nunosousa/AudioAmplifier/electronics/README.md

# Electronics

`audio-amplifier/` is the primary KiCad design. Its `dsp/` and `simulation/`
subdirectories keep tool-specific project data alongside the hardware design.
`datasheets/` holds component reference material used by the design.

Keep KiCad's top-level project file and all hierarchical sheets in
`audio-amplifier/`, because the sheet hierarchy uses relative paths.
