nunosousa/AudioAmplifier/mechanical/enclosure/README.md

# Enclosure CAD

- `source/` — editable native CAD files.
- `exports/` — neutral exchange formats, such as STEP and DXF.
- `drawings/` — released fabrication drawings and PDFs.

Use versioned filenames for released exports and drawings. Keep the editable
source that produced every released file in `source/`.
