nunosousa/AudioAmplifier/docs/ADAU1701_INTEGRATION.md

# ADAU1701 integration plan

This is a schematic-preparation guide for integrating the ADAU1701 into the
main 2.1 amplifier. It is not a finished schematic or a substitute for the
current Analog Devices datasheet and SigmaStudio documentation.

The package pin names/numbers below are transcribed from the embedded KiCad
symbol in [`dsp.kicad_sch`](../electronics/audio-amplifier/dsp.kicad_sch). Confirm every
pin function, electrical limit, recommended connection, component value, and
layout rule against the official
[ADAU1701 datasheet](https://www.analog.com/media/en/technical-documentation/data-sheets/ADAU1701.pdf)
before editing the circuit or releasing a board. Datasheet retrieval was not
available while preparing this plan, so no unverified component values are
specified here.

## Intended audio-channel mapping

The top-level sheet currently proposes these signal interfaces:

| Audio channel | Proposed DSP DAC | DSP-sheet outputs | Destination |
| --- | --- | --- | --- |
| Left | VOUT0 (pin 46) | `OUT_HIGH_P_LEFT`, `OUT_HIGH_N_LEFT` | Left differential input of stereo amplifier |
| Right | VOUT1 (pin 45) | `OUT_HIGH_P_RIGHT`, `OUT_HIGH_N_RIGHT` | Right differential input of stereo amplifier |
| Subwoofer | VOUT2 (pin 44) | `OUT_LOW_P`, `OUT_LOW_N` | Differential input of mono amplifier |
| Spare | VOUT3 (pin 43) | Not assigned | Reserve until channel needs are confirmed |

This is a proposed allocation, not a confirmed SigmaStudio routing. Verify it
against the DSP program before relying on the labels. The ADAU1701 has four
single-ended DAC outputs, whereas the three TPA3116D2 channels are presented
with differential input pairs. Therefore, the three proposed output pairs
require suitable analog output-driver circuits; the positive and negative
inputs must not be assumed to be separate DAC outputs or connected directly
to ground.

## Current SigmaStudio processing

The project owner reports that the current SigmaStudio design contains:

1. Bass and treble adjustment on the stereo input path. Each uses a DC Input
   Entry parameter to control a second-order filter block.
2. One DC Input Entry parameter controlling the cutoff frequency for the
   crossover filters: paired second-order high-pass sections for the stereo
   outputs (fourth-order overall) and paired second-order low-pass sections
   for the subwoofer output (fourth-order overall).
3. Separate master-volume blocks for the stereo outputs and the subwoofer
   output.

These are functional processing blocks in the SigmaStudio project; the
hardware/control path that will set their parameters is still undecided. A
SigmaStudio DC Input Entry value does not, by itself, define a physical knob,
controller, user interface, or persistent setting.

Before calling the crossover Linkwitz–Riley, inspect its actual biquad
coefficients and response. Cascading two identical second-order Butterworth
sections at the same cutoff yields a fourth-order Linkwitz–Riley response
(nominally -6 dB per branch at crossover); a generic fourth-order Butterworth
filter has different section Q values and a different crossover sum. Confirm
that the high- and low-pass branches use the intended response, share the same
cutoff parameter, and sum correctly in magnitude and phase with the intended
speaker polarity and acoustic alignment.

The cutoff control should update all affected stereo high-pass and mono
low-pass coefficients together. Check the SigmaStudio implementation to ensure
the coefficient changes remain stable throughout the allowed range and do not
cause audible zipper noise; use suitable parameter smoothing or a controlled
update if needed. Limit the adjustment range to values supported by the
filters, sample rate, speakers, and output-stage headroom.

The owner intends one shared master volume for all outputs plus a separate
subwoofer level trim. Map the stereo and subwoofer volume blocks to that
behavior (the stereo block provides master volume; the subwoofer block
combines master volume with the additional subwoofer trim, or an equivalent
DSP arrangement). Verify mute behavior, startup gain, parameter limits, and
clipping/headroom across all outputs.

## Pin-by-pin connection checklist

“Required treatment” describes what the schematic must account for. It does
not prescribe a final strap, rail, or component value.

| Pin | Name | Planned treatment | Status in current DSP sheet |
| ---: | --- | --- | --- |
| 1 | AGND | Connect to the analog ground reference per the vendor layout guidance. | Open |
| 2 | ADC0 | Condition and connect one line-input channel; verify common-mode, range, and anti-alias filtering. | Open |
| 3 | ADC_RES | Use the datasheet-specified 18 kohm, 1% external resistor for the selected 48 kHz sample rate. | Open |
| 4 | ADC1 | Condition and connect the other line-input channel; verify common-mode, range, and anti-alias filtering. | Open |
| 5 | `~{RESET}` | Define reset state and release timing; choose pull-up/reset supervision as needed. | Open |
| 6 | SELFBOOT | Strap for the selected startup method; document whether external EEPROM self-boot is used. | Open |
| 7 | ADDR0 | Strap/select only as required by the chosen control-bus configuration. | Open |
| 8 | MP4 | Assign a documented GPIO/serial function or set a defined unused state. | Open |
| 9 | MP5 | Assign a documented GPIO/serial function or set a defined unused state. | Open |
| 10 | MP1 | Assign a documented GPIO/serial function or set a defined unused state. | Open |
| 11 | MP0 | Assign a documented GPIO/serial function or set a defined unused state. | Open |
| 12 | DGND | Connect to the ground reference per the vendor layout guidance. | Open |
| 13 | DVDD | Connect to the datasheet-specified digital supply and local decoupling. | Open |
| 14 | MP7 | Assign a documented GPIO/serial function or set a defined unused state. | Open |
| 15 | MP6 | Assign a documented GPIO/serial function or set a defined unused state. | Open |
| 16 | MP10 | Assign a documented GPIO/serial function or set a defined unused state. | Open |
| 17 | VDRIVE | Use only as specified for the supported interface voltage; do not treat as a general-purpose supply. | Open |
| 18 | IOVDD | Connect to the datasheet-specified I/O supply and local decoupling. | Open |
| 19 | MP11 | Assign a documented GPIO/serial function or set a defined unused state. | Open |
| 20 | ADDR1/CDATA/WB | Configure for the selected control/self-boot interface; make the strap and bus function explicit. | Open |
| 21 | CLATCH/WP | Connect/configure for the selected control/self-boot interface. | Open |
| 22 | SDA/COUT | Connect/configure for the selected control/self-boot interface; add required pull-ups if applicable. | Open |
| 23 | SCL/CCLK | Connect/configure for the selected control/self-boot interface; add required pull-ups if applicable. | Open |
| 24 | DVDD | Connect to the specified digital supply and local decoupling. | Open |
| 25 | DGND | Connect to the ground reference per the vendor layout guidance. | Open |
| 26 | MP9 | Assign a documented GPIO/serial function or set a defined unused state. | Open |
| 27 | MP8 | Assign a documented GPIO/serial function or set a defined unused state. | Open |
| 28 | MP3 | Assign a documented GPIO/serial function or set a defined unused state. | Open |
| 29 | MP2 | Assign a documented GPIO/serial function or set a defined unused state. | Open |
| 30 | RSVD | Apply the exact reserved-pin treatment in the datasheet; do not infer a connection from the symbol’s passive type. | Open |
| 31 | OSCO | Connect only as required by the selected crystal/clock topology. | Open |
| 32 | MCLKI | Provide the master clock using a datasheet-compliant source and layout. | Open |
| 33 | PGND | Connect to the specified ground reference with the vendor-recommended layout. | Open |
| 34 | PVDD | Connect to the specified supply and local decoupling. | Open |
| 35 | PLL_LF | Add the specified loop-filter network with vendor-recommended placement. | Open |
| 36 | AVDD | Connect to the specified analog supply and local decoupling. | Open |
| 37 | AGND | Connect to the analog ground reference per the vendor layout guidance. | Open |
| 38 | PLL_MODE0 | Strap for the selected master-clock/PLL operating mode. | Open |
| 39 | PLL_MODE1 | Strap for the selected master-clock/PLL operating mode. | Open |
| 40 | CM | Add the specified common-mode bypass/filter connection. | Open |
| 41 | FILTD | Add the specified DAC filter connection and place it close to the IC. | Open |
| 42 | AGND | Connect to the analog ground reference per the vendor layout guidance. | Open |
| 43 | VOUT3 | Reserve as the spare DAC unless the channel plan changes; provide the specified output network if used. | Open |
| 44 | VOUT2 | Proposed subwoofer DAC; add its output network and differential driver. | Open |
| 45 | VOUT1 | Proposed right-channel DAC; add its output network and differential driver. | Open |
| 46 | VOUT0 | Proposed left-channel DAC; add its output network and differential driver. | Open |
| 47 | FILTA | Add the specified ADC filter connection and place it close to the IC. | Open |
| 48 | AVDD | Connect to the specified analog supply and local decoupling. | Open |

The repeated supply and ground pins are intentional: connect every package pin.
Use the datasheet's recommended decoupling, ground, and placement scheme rather
than treating the repeated pins as optional.

## Circuit blocks to draw

### 1. Power and reference

- Choose the system input supply and derive every ADAU1701 rail from the
  datasheet limits and the rest of the design.
- Show each supply domain separately (`AVDD`, `DVDD`, `PVDD`, `IOVDD`) even
  where they ultimately share a source. Identify any filtering or ferrite
  isolation, and place decoupling at the corresponding device pins.
- Connect all ground pins. Plan a continuous, low-impedance reference and
  partition noisy Class-D return-current paths by placement/routing rather
  than introducing an unreviewed ground split.
- Add the ADC reference, PLL loop filter, DAC/ADC filter capacitors, and
  common-mode bypass exactly as specified by the current datasheet.

**Still needed:** supply voltage/current budget, rail architecture, regulator
choices, and datasheet-verified component values.

### 2. Clock, reset, boot, and control

- Select either a crystal/resonator or external master-clock source and define
  its frequency and startup behavior. Configure both PLL mode pins accordingly.
- Choose and document the boot path: for example, self-boot from an external
  EEPROM or program/configure the DSP from a controller. Check that the selected
  strap states and pin multiplexing support the chosen path.
- Define the roles of the multifunction pins before assigning GPIOs or serial
  audio ports. Give every unused input or multifunction pin a documented,
  datasheet-compliant state.
- The current UI proposal uses an RP2350 with a 320 × 240 colour display, one
  rotary encoder, and dedicated parameter buttons to update master volume,
  bass, treble, sub trim, and crossover values. Spectrum and VU views require
  DSP level/spectrum telemetry in addition to parameter control. Define the
  display, parameter-control, telemetry, GPIO, and SWD interfaces; reserve
  debug access and verify target-voltage and probe requirements.
- Specify control-bus wiring, pull-ups/logic voltage, address straps, reset
  ownership, DSP parameter-update mechanism, and relationship to amplifier
  mute and power control.

**Still needed:** boot method, exact MCU, master-clock source, and confirmed
parameter interface.

### 3. Stereo ADC input conditioning

- Preserve left/right channel identity from the input connector through the
  preamp to ADC0/ADC1 and into the SigmaStudio project.
- The ADAU1701 ADC inputs are current inputs, not conventional voltage inputs.
  At 48 kHz, the datasheet specifies 100 uA rms full scale with an external
  18 kohm ADC_RES resistor (20 kohm including the internal 2 kohm). The ADC
  input pins sit at approximately 1.5 V common mode.
- At 48 kHz, choose each ADC0/ADC1 external series resistor from the desired
  full-scale input voltage:
  `R_input,total = V_input,FS(rms) * 10 kohm`, and
  `R_input,external = R_input,total - 2 kohm` (the internal input resistance).
  The selected target is 2.0 Vrms full scale, so use 18 kohm external series
  resistors for ADC0 and ADC1. Keep ADC_RES at 18 kohm external for 48 kHz.
  Use 1% resistors and verify the datasheet's recommended matching relationship.
  This nominally maps 0.5 Vrms to 25% full scale (about -12 dBFS) and 0.2 Vrms
  to 10% full scale (about -20 dBFS), before the small source-side loading
  loss.
- Current input specification: a pair of unbalanced RCA line inputs, expected
  source impedance 50 ohm to 2.5 kohm, 0.5 Vrms nominal, 0.2 Vrms minimum,
  5.65 Vpp maximum, with a superimposed DC component from 0 V to +1 V. The
  impedance range is a reasonable broad design target, but verify the actual
  source and any SCART-to-RCA adapter documentation: SCART is a connector
  standard, not a guarantee of identical audio output impedance or level from
  every device.
- The proposed signal path in the preamp schematic is a 100 ohm series resistor
  and 1 nF shunt capacitor for first-order RF attenuation, followed by a
  220 kohm source-side drain resistor, 22 uF series coupling capacitor, and
  100 kohm bias resistor to +4.5 V (V/2). The conditioned signal is buffered
  by a unity-gain voltage follower before the ADAU1701 ADC.
- The 100 ohm series resistor and 1 nF shunt capacitor form the input RF
  low-pass. Including the 50 ohm to 2.5 kohm source impedance and the 220 kohm
  drain resistor, the estimated corner is approximately 1.06 MHz down to
  61.9 kHz, respectively. These estimates assume a low-impedance ground at
  the shunt capacitor and nominal component values. The filter attenuates RF
  above its corner; it is not a brick-wall filter and does not replace good
  connector, grounding, and layout practice.
- With the 22 uF coupling capacitor acting as a short at audio frequencies,
  the source sees approximately 220 kohm in parallel with the 100 kohm bias
  path (about 68.8 kohm), assuming the +4.5 V bias node is AC-stiff. A 2.5 kohm
  source would therefore cause roughly 3.6% level loss (about 0.32 dB) before
  other loading and tolerance effects. This is generally modest, but include
  the loading in gain/headroom calculations.
- With the source unplugged and ideal low-impedance ground and V/2 references,
  the 22 uF capacitor sees about 220 kohm + 100 kohm. This gives an approximate
  7.0 second time constant (about 0.023 Hz corner). The drain resistor helps
  prevent the source-side input node from floating, but this relatively long
  discharge time does not guarantee click-free hot-plugging. Source impedance
  changes the time constant while connected.
- The owner confirms that 5.65 Vpp means a maximum sine-wave input and that
  the +1 V DC offset may coexist with that signal. It is 2.0 Vrms and 2.825 V
  AC peak; with +1 V DC, the RCA source ranges from -1.825 V to +3.825 V.
  The source-side 22 uF capacitor blocks this DC component. The selected
  2.0 Vrms ADC full-scale target leaves no intentional headroom for a
  2.0 Vrms sine at the buffer output. Do not rely on the small and
  source-impedance-dependent passive input loss as headroom; account for
  source level tolerance and resistor tolerance, and verify clipping with the
  worst-case input.
- RCA inputs are user-accessible and hot-plugged. Decide the ESD and fault
  model (connector contact discharge, cable discharge, accidental DC/overload,
  and power-off conditions). Place a low-leakage, suitably low-capacitance
  protection device close to each RCA center pin, with a short return to the
  intended chassis/ESD return. Coordinate any signal-to-rail clamps with the
  100 ohm series resistor and ensure clamps cannot back-power unpowered analog
  rails. The 100 ohm resistor and 220 kohm drain are not, by themselves,
  robust ESD protection. Keep protection leakage and capacitance low enough to
  avoid bias error, RF-filter changes, or audible distortion.
- Ensure input protection does not clamp the normal audio waveform. A simple
  diode clamp from the RCA center pin to ground would conduct on the permitted
  negative audio swing and distort it. At the connector, choose a protection
  device whose stand-off/clamping behavior tolerates the defined normal
  envelope, or place any tighter clamp after the coupling capacitor at a
  correctly biased node. Verify protection against both the continuous
  operating range and the selected ESD/overload test levels.
- Treat the RCA shield as the audio return. Plan its connection to analog
  ground and chassis so cable/shield and ESD currents do not flow through
  sensitive DSP/op-amp return paths; finalize the chassis-grounding strategy
  with the enclosure and power-supply grounding plan.
- Verify the polarized coupling capacitor's positive terminal faces the
  +4.5 V bias side, with suitable voltage rating and leakage. Confirm that
  +4.5 V is sufficiently low-noise and low-impedance for both channel bias
  resistors, and verify the unity-gain follower configuration and supplies.
- **Critical ADC interface check:** biasing the follower input to +4.5 V
  means its output will also sit near +4.5 V DC. Do not connect that output
  directly to an ADAU1701 ADC pin: the ADC input common mode is about +1.5 V.
  A candidate interface is to AC-couple the follower output, then feed the ADC
  through the correctly sized 1% voltage-to-current series resistor; the ADC
  pin's internal common mode establishes its DC operating point. Verify this
  arrangement, coupling-capacitor polarity/value, current limits, and resistor
  matching against the current datasheet and an analog simulation before
  committing the circuit. Alternatively, redesign the buffer bias so its
  output common mode is compatible with the ADC input.
- Measure or establish the actual source impedance and output level for the
  intended RCA sources and SCART adapter. Check
  source loading, protection, component tolerances, op-amp output swing, and
  the ADAU1701 input-current full scale and clipping behavior at minimum,
  nominal, and maximum input. Record expected AC/DC levels at the connector,
  buffer output, and ADC pins.
- Keep amplifier mute active during power-up and DSP initialization; do not
  rely on the 220 kohm drain resistor alone to suppress connection or startup
  thumps.

### 4. Three DAC output-driver channels

For each of left, right, and subwoofer:

1. Assign one DAC channel and record the matching SigmaStudio output.
2. Add the datasheet-recommended DAC output network.
3. Design a driver that provides the required differential signal to one
   TPA3116D2 input pair, including correct amplitude, polarity, bias/common
   mode, and source impedance.
4. Verify the amplifier input limits and gain together with DSP output level
   and any intended equalization boost.
5. Add mute/startup behavior that avoids audible transients.

Do not treat an output pair named `P`/`N` in the hierarchy as a differential
output of the ADAU1701 itself: it is the proposed output of the external analog
driver. Keep a clear spare-channel policy for VOUT3.

**Still needed:** intended amplifier gain, required DAC-to-amplifier level,
driver topology, component availability, and whether a shared or per-channel
mute is required.

## Requirements to settle before final values

- Exact RCA source/SCART-adapter behavior and connector/chassis grounding;
  confirm whether the specified maximum AC level and +1 V DC offset can occur
  simultaneously and establish absolute peak limits.
- Required supply input, available power, speaker impedance, and target output
  power per channel.
- Crossover frequency and response, subwoofer summing rule, EQ range/boost,
  and master-volume range.
- Front-panel electrical details (display controller/interface, encoder/button
  circuits, parameter ranges, startup defaults, saved-setting policy, and DSP
  level/spectrum telemetry).
- Whether the design needs selectable inputs, status indication, fault
  reporting, or firmware-updatable DSP parameters.

## Bring-up and validation checklist

- [ ] Review each of the 48 package pins against the current datasheet.
- [ ] Run KiCad ERC; resolve errors and document intentional exceptions.
- [ ] Generate the KiCad netlist and confirm ADC, DAC, supply, clock, reset,
      control-bus, and mute nets.
- [ ] Before powering the DSP, verify the ADC input path against the datasheet:
      18 kohm, 1% external resistors at ADC0/ADC1 and ADC_RES at 48 kHz;
      confirm the external ADC_RES resistor is actually connected and the
      three resistors meet the specified matching/tolerance guidance.
- [ ] Check the polarity and DC ratings of the source-side and buffer-output
      coupling capacitors. Confirm the follower output is AC-coupled before
      each ADC resistor and that no +4.5 V DC path reaches an ADC pin.
- [ ] With power amplifiers disconnected and the audio/control rails current
      limited, verify analog supplies, V/2 bias, op-amp input/output common
      modes, and ADC pin DC common mode before applying a signal.
- [ ] Apply a known 1 kHz sine at nominal 0.5 Vrms, then verify both channels'
      ADC input levels and channel mapping. Increase toward the specified
      2.0 Vrms maximum only after confirming the analog stage remains within
      its input/output limits; confirm ADC clipping is absent at the intended
      maximum and document the actual margin.
- [ ] Test representative source impedances at the design endpoints (50 ohm
      and 2.5 kohm), and verify input loading, channel balance, low-frequency
      response, RF-filter behavior, and recovery after signal removal.
- [ ] If testing the specified +1 V source DC offset, first verify all
      component/op-amp ratings and use the source-side coupling capacitor;
      measure the ADC-side DC common mode and ensure the offset does not pass
      through to the ADC.
- [ ] Keep the power amplifiers disconnected until ADC scaling, clipping,
      mute/startup sequencing, and output-stage levels have been verified.
- [ ] Verify the SigmaStudio design has the same ADC/DAC channel mapping and
      startup parameter values as the schematic.
- [ ] Test input clipping margin and output levels at minimum/nominal/maximum
      input.
- [ ] Measure left/right/sub frequency response, crossover summing, phase,
      channel balance, noise, and mute/startup transients.
- [ ] Check the DSP and output-driver supplies for noise under Class-D load.

## Current repository-specific findings

- The parent hierarchy currently carries `IN_LEFT` and `IN_RIGHT` into the DSP
  sheet from the reduced preamp, and carries six proposed differential outputs
  toward the stereo and mono TPA3116D2 sheets.
- The DSP sheet now has 18 kohm series resistors on the two ADC inputs and
  partial wiring to the ADAU1701. The required external ADC_RES resistor is
  still absent, resistor tolerance/matching is not recorded, and the DSP
  power, clock, reset, boot, and other required pin circuitry remain
  incomplete. The schematic is not ready to power or fabricate.
- The preamplifier sheet now AC-couples the two buffered outputs before they
  enter the DSP sheet. Verify the output-coupling capacitor polarity and
  confirm the ADC pins remain at their datasheet-specified common mode.
- The owner-reported SigmaStudio chain includes bass and treble filters, a
  shared adjustable crossover cutoff, and separate stereo/subwoofer volume
  blocks. The intended control behavior is one shared master volume plus a
  subwoofer trim. Verify that the actual SigmaStudio graph implements that
  behavior, and check the generated files together before hardware bring-up.
- The parent `MCU` sheet is empty. The controller need is therefore an
  architecture decision, not an implemented feature.
- The current PCB is empty and needs to be rebuilt after the DSP sheet and its
  analog interface are complete.
