nunosousa/AudioAmplifier/electronics/audio-amplifier/simulation/Filter Design.xlsx

Fourth-order Sallen & Key Butterworth highpass filter, implemented in two stages. Type: Linkwitz-Riley
two cascaded 2nd-order Butterworth filters with the same cutoff frequency
 | Calculated
Q | 0.7071067812
f0 | 120 | Hz
 |  |  |  |  | Prefered
R2 | 10000 | Ω | → | R2 | 10000 | Ω
R1 | 5000 | Ω | → | R1 | 5000 | Ω
C1, C2 | 187.5658992 | nF | → | C1, C2 | 200 | nF
 |  |  |  | Q | 0.7071067812
 |  |  |  | f0 | 112.5395395 | Hz
Fourth-order Sallen & Key Butterworth lowpass filter, implemented in two stages. Type: Linkwitz-Riley
two cascaded 2nd-order Butterworth filters with the same cutoff frequency
 | Calculated
Q | 0.7071067812
f0 | 120 | Hz
 |  |  |  |  | Prefered
C2 | 100 | nF | → | C2 | 100 | nF
C1 | 200 | nF | → | C1 | 200 | nF
R1, R2 | 9378.29496 | Ω | → | R1, R2 | 10000 | Ω
 |  |  |  | Q | 0.7071067812
 |  |  |  | f0 | 112.5395395 | Hz
