nunosousa/AudioAmplifier/electronics/archive/README.md

# Legacy source material

This directory holds unintegrated design source retained for historical
reference. Nothing here is part of the active KiCad sheet hierarchy or the
current product scope.
