nunosousa/AudioAmplifier/docs/archive/README.md

# Archived interface studies

These are superseded concepts retained for design history. They are not current
hardware or firmware requirements.

`front-panel-seven-segment.svg` documents the previous five-control,
seven-segment front-panel proposal. The active design is described in
`../FRONT_PANEL.md`.
