nunosousa/AudioAmplifier/electronics/audio-amplifier/AudioAmplifier.pdf

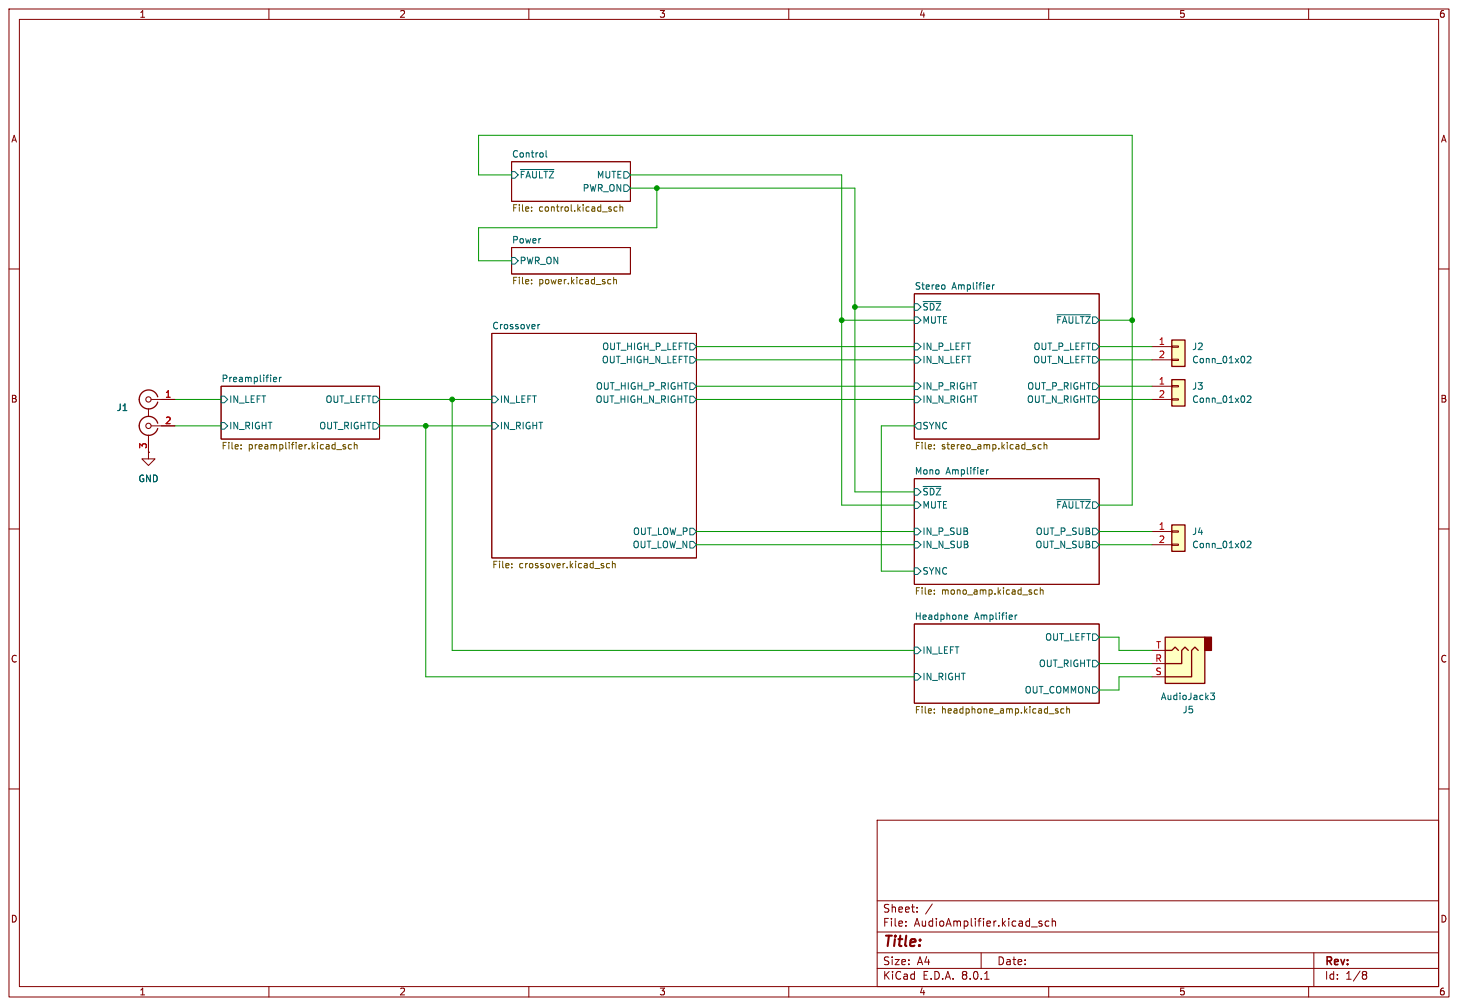
[picture p2: page 1]

SYNC Mono Amplifier File: mono_amp.kicad_sch

Id: 1/8 Title: File: AudioAmplifier.kicad_sch Sheet: /

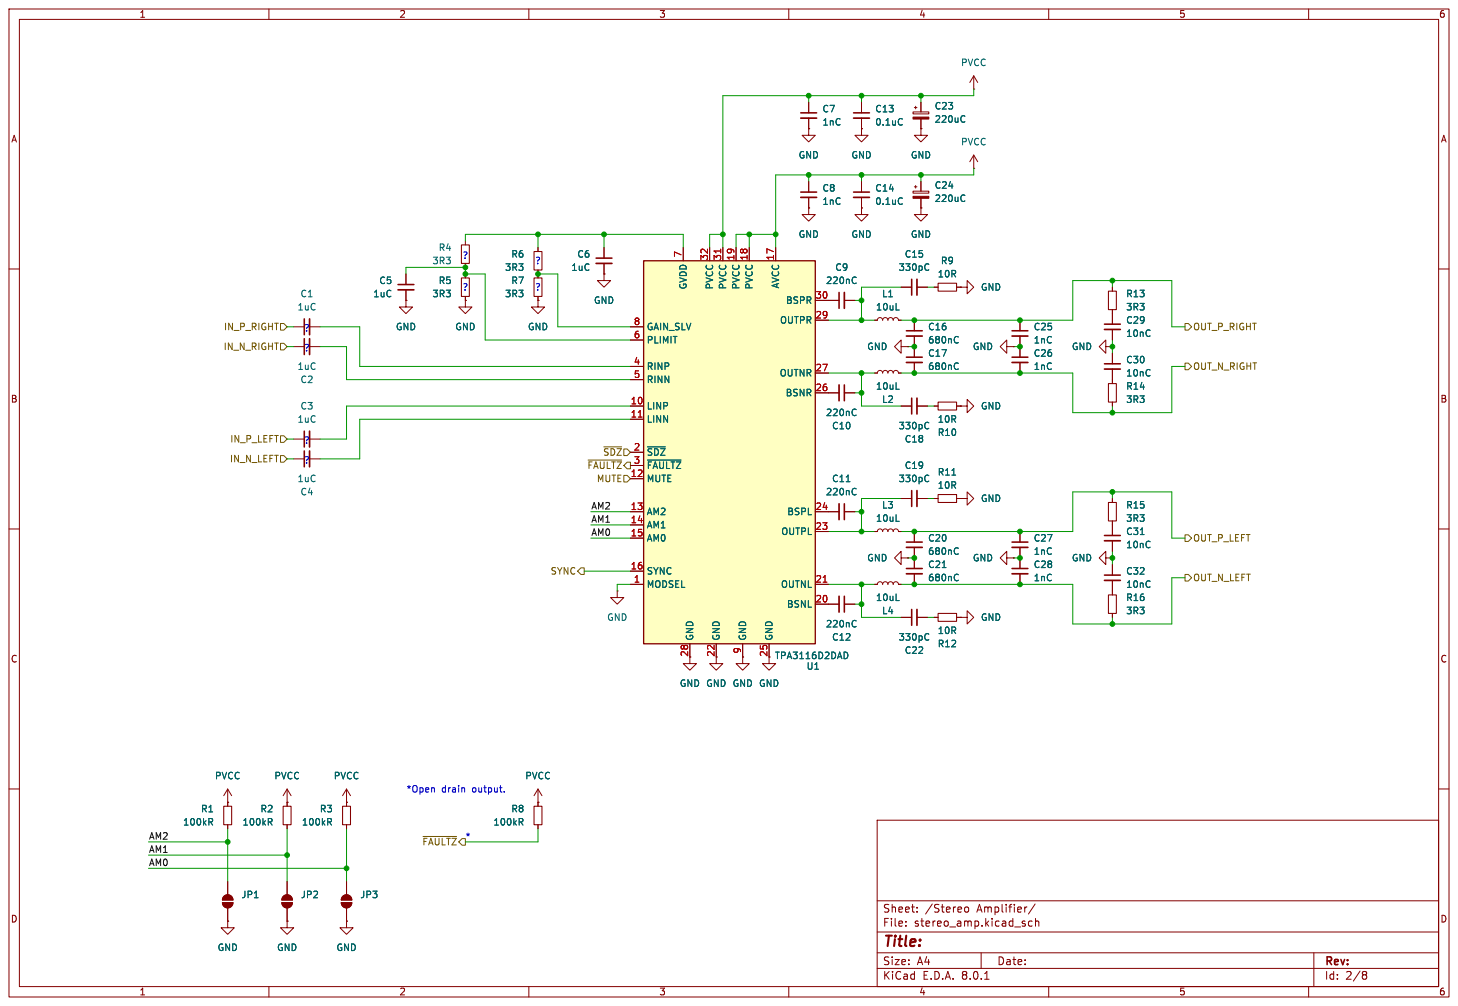
[picture p3: page 2]

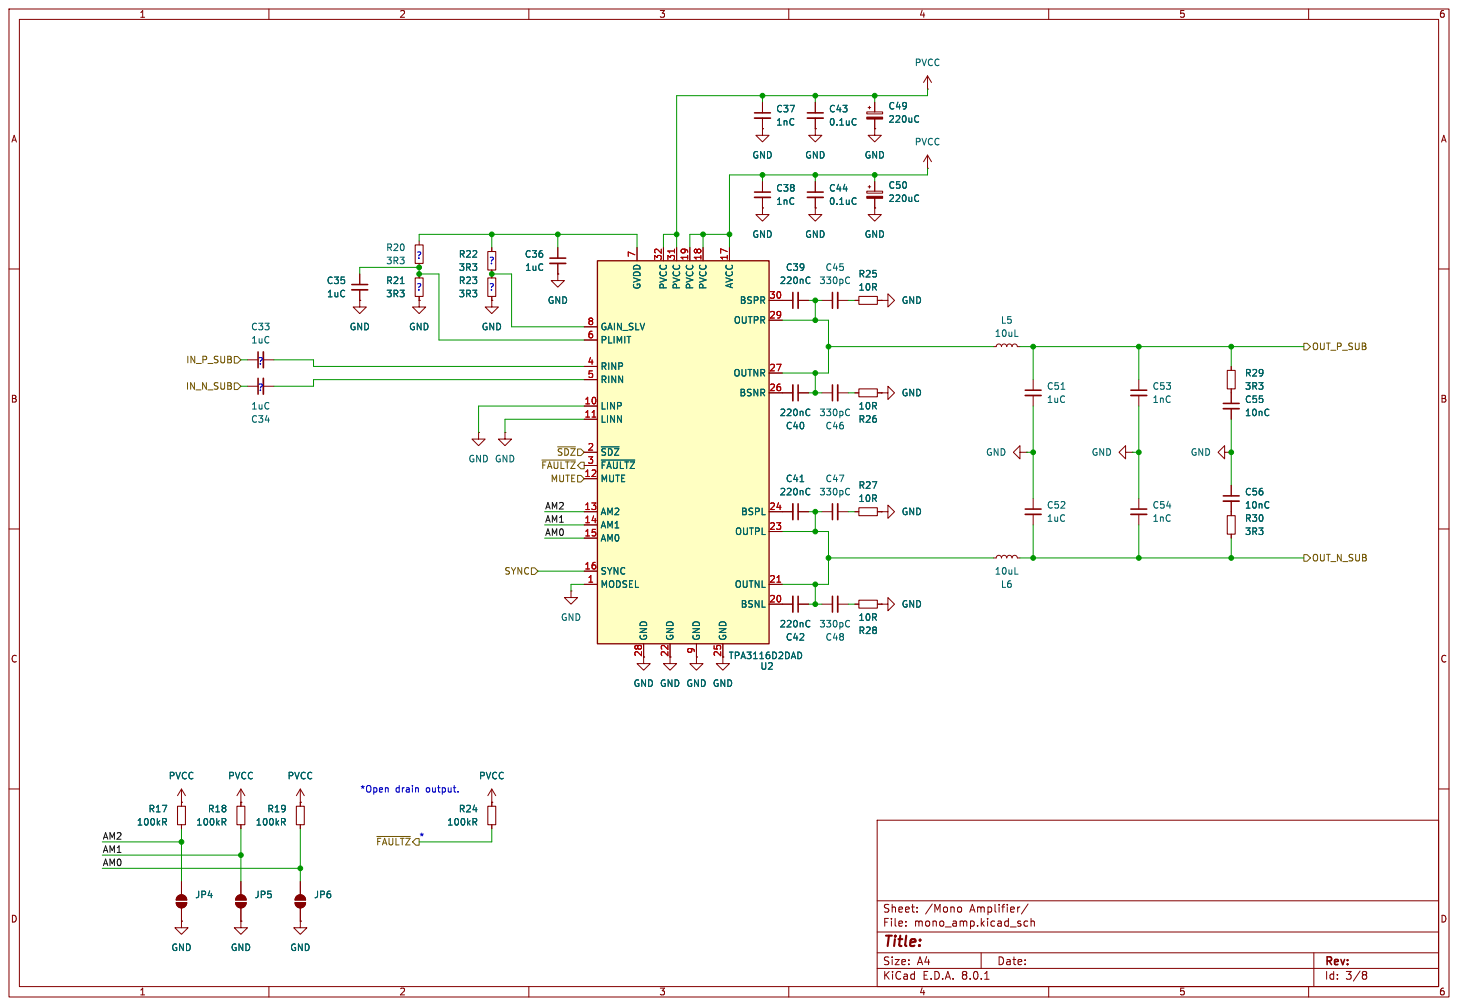
[picture p4: page 3]

9 GND GND GND GND

Id: 3/8 Title: File: mono_amp.kicad_sch Sheet: /Mono Amplifier/ JP6 R19

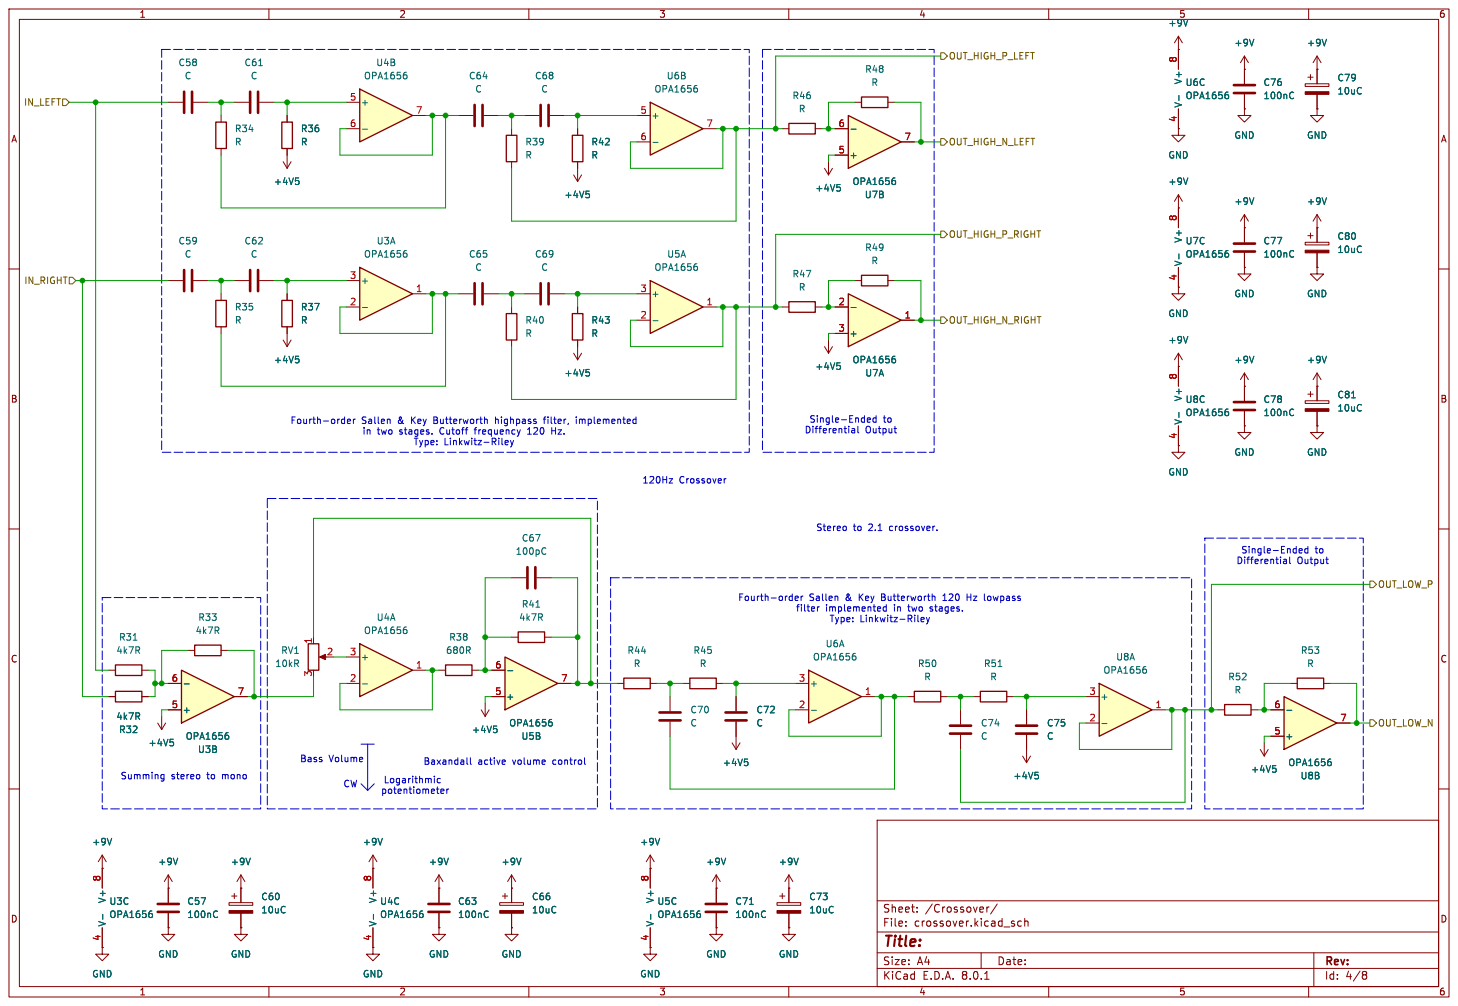
[picture p5: page 4]

potentiometer Bass Volume CW

Id: 4/8 Title: File: crossover.kicad_sch Sheet: /Crossover/

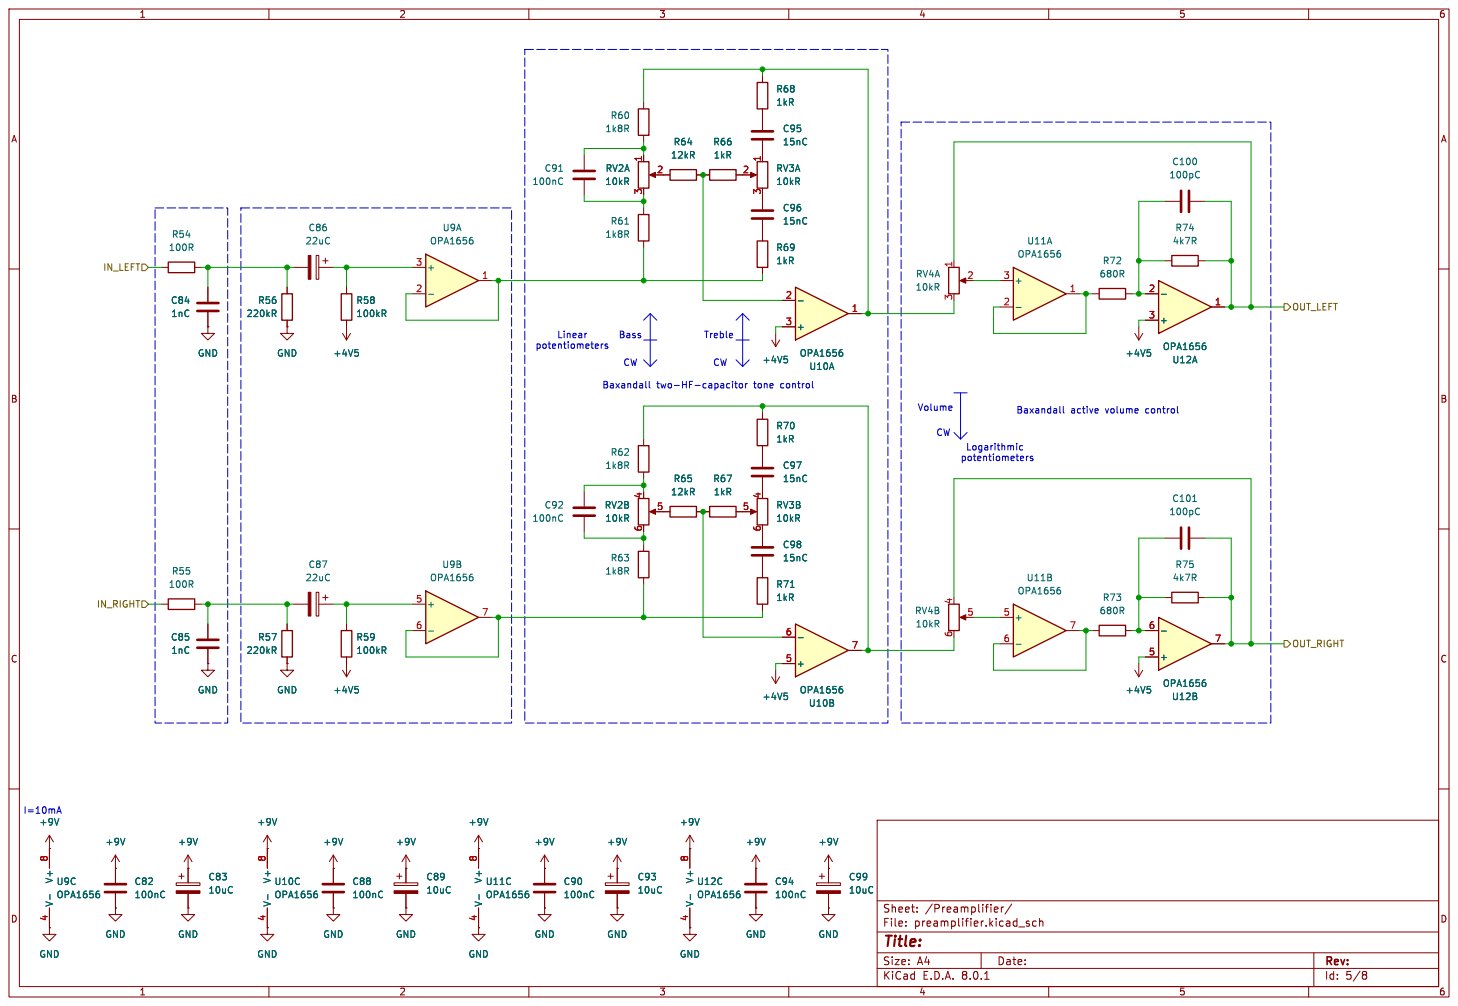
[picture p6: page 5]

Id: 5/8 Title: File: preamplifier.kicad_sch Sheet: /Preamplifier/

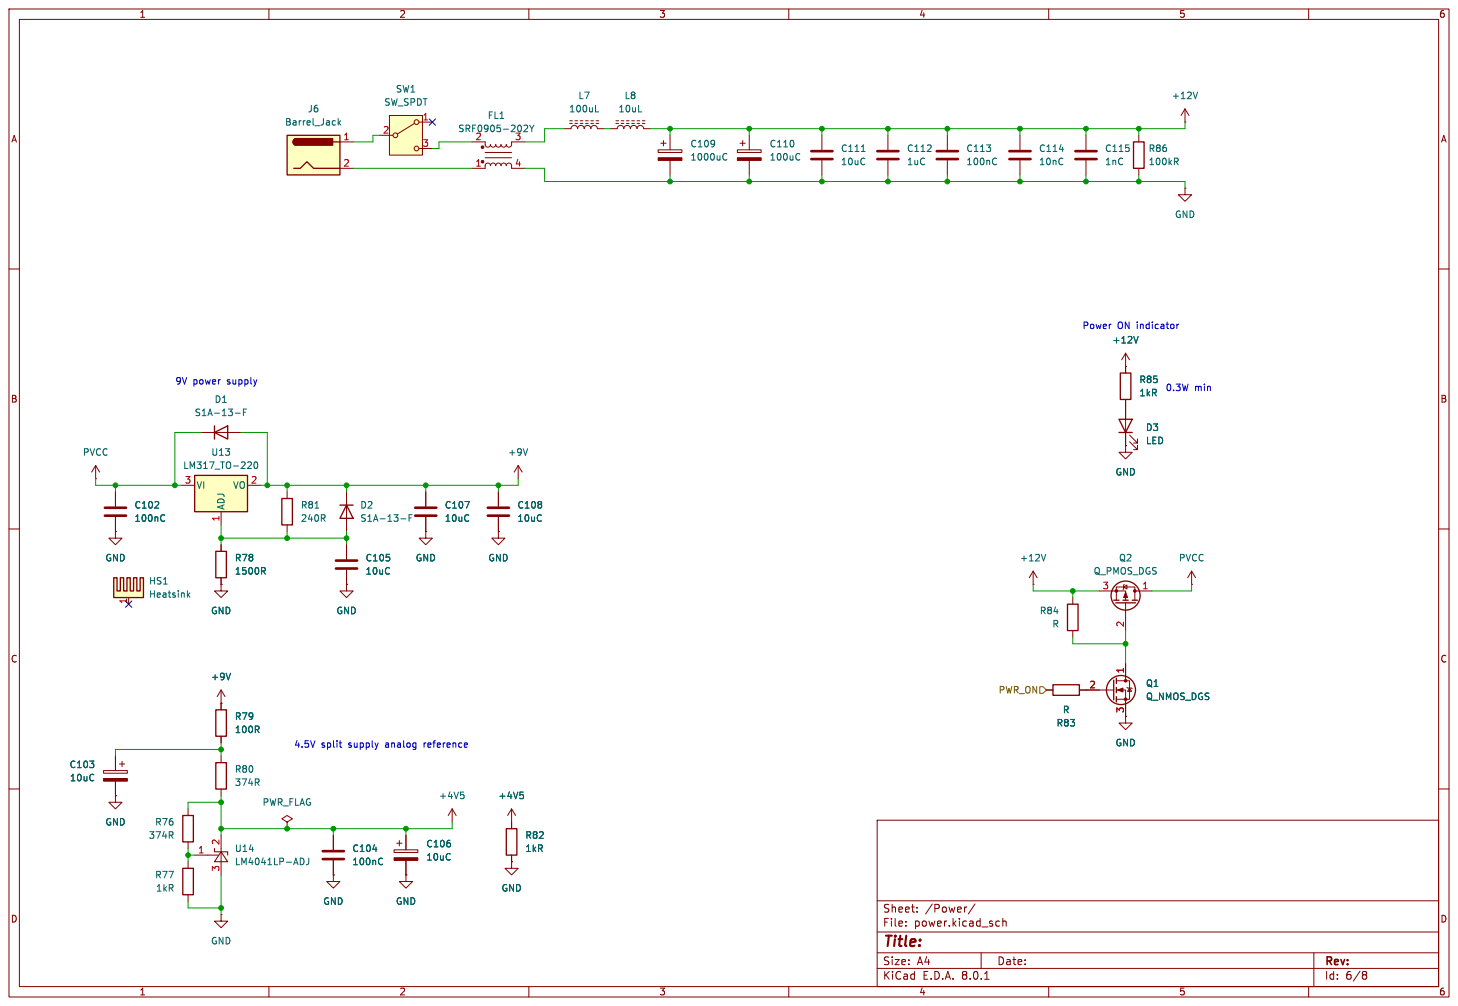
[picture p7: page 6]

0.3W min Power ON indicator 4.5V split supply analog reference

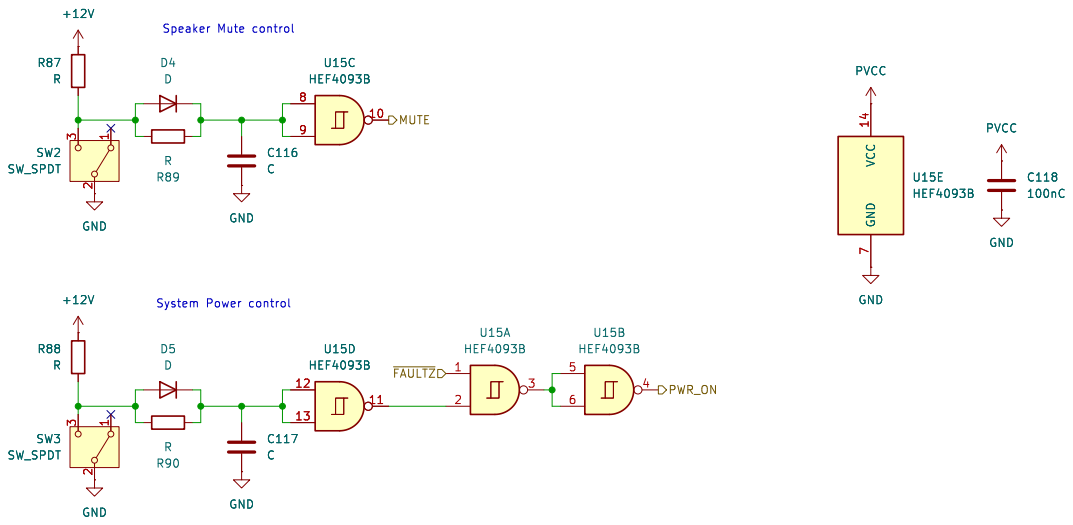
[picture p8: page 7]

Id: 7/8 Title: File: control.kicad_sch Sheet: /Control/ 1

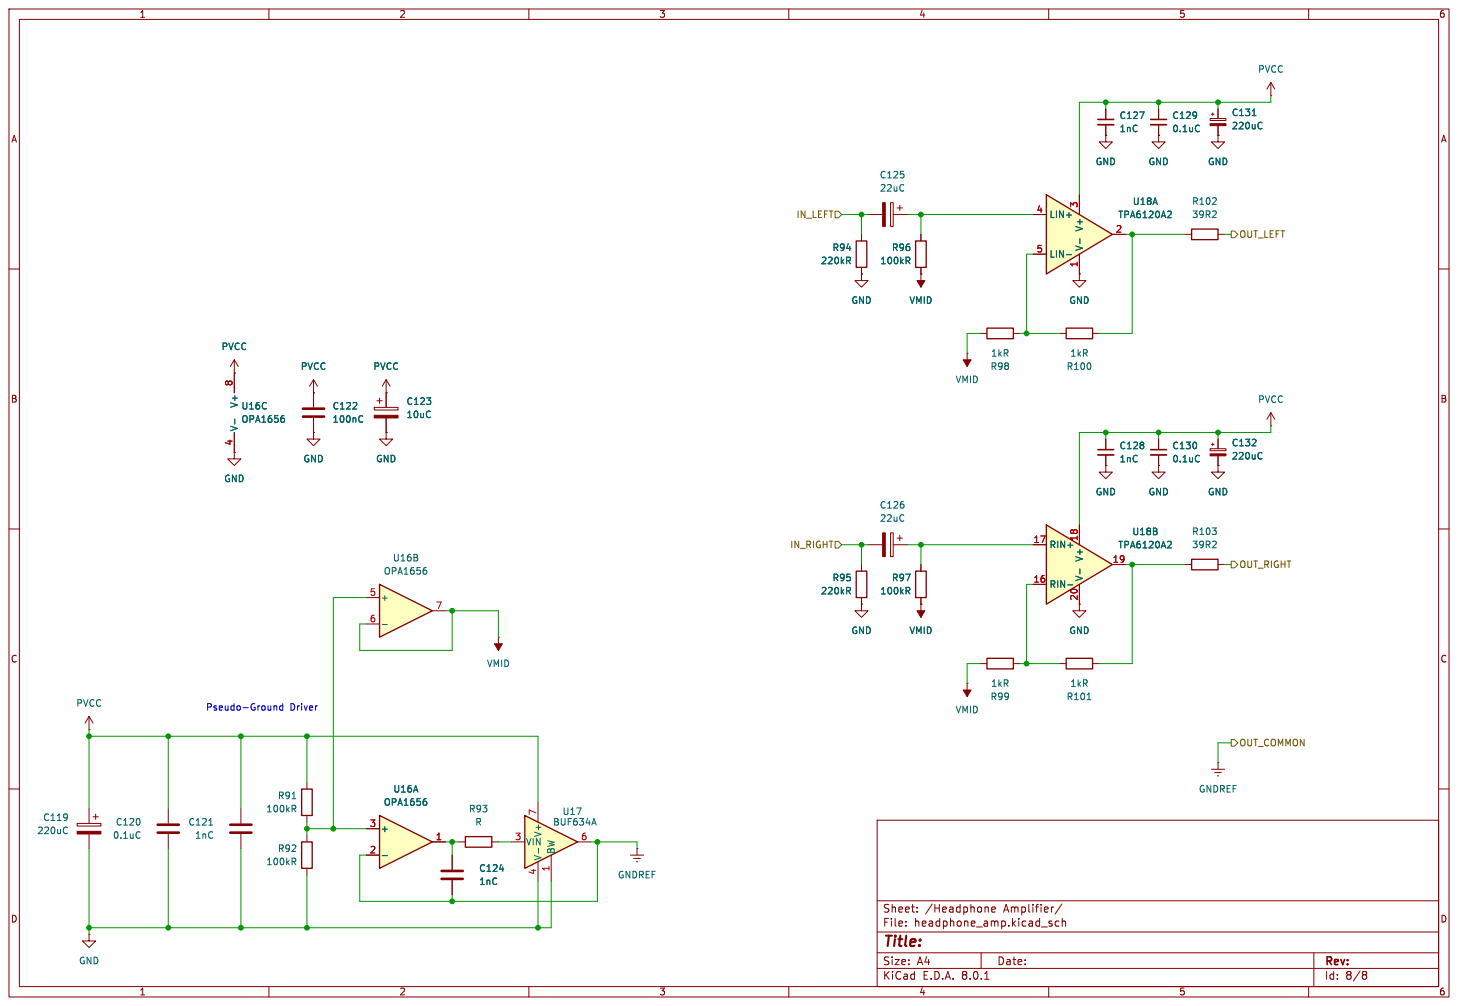
[picture p9: page 8]
