nunosousa/AudioAmplifier/electronics/audio-amplifier/AudioAmplifier.kicad_sch

## KiCad design electronics/audio-amplifier/AudioAmplifier.kicad_sch (2026-11-09, an earlier design)

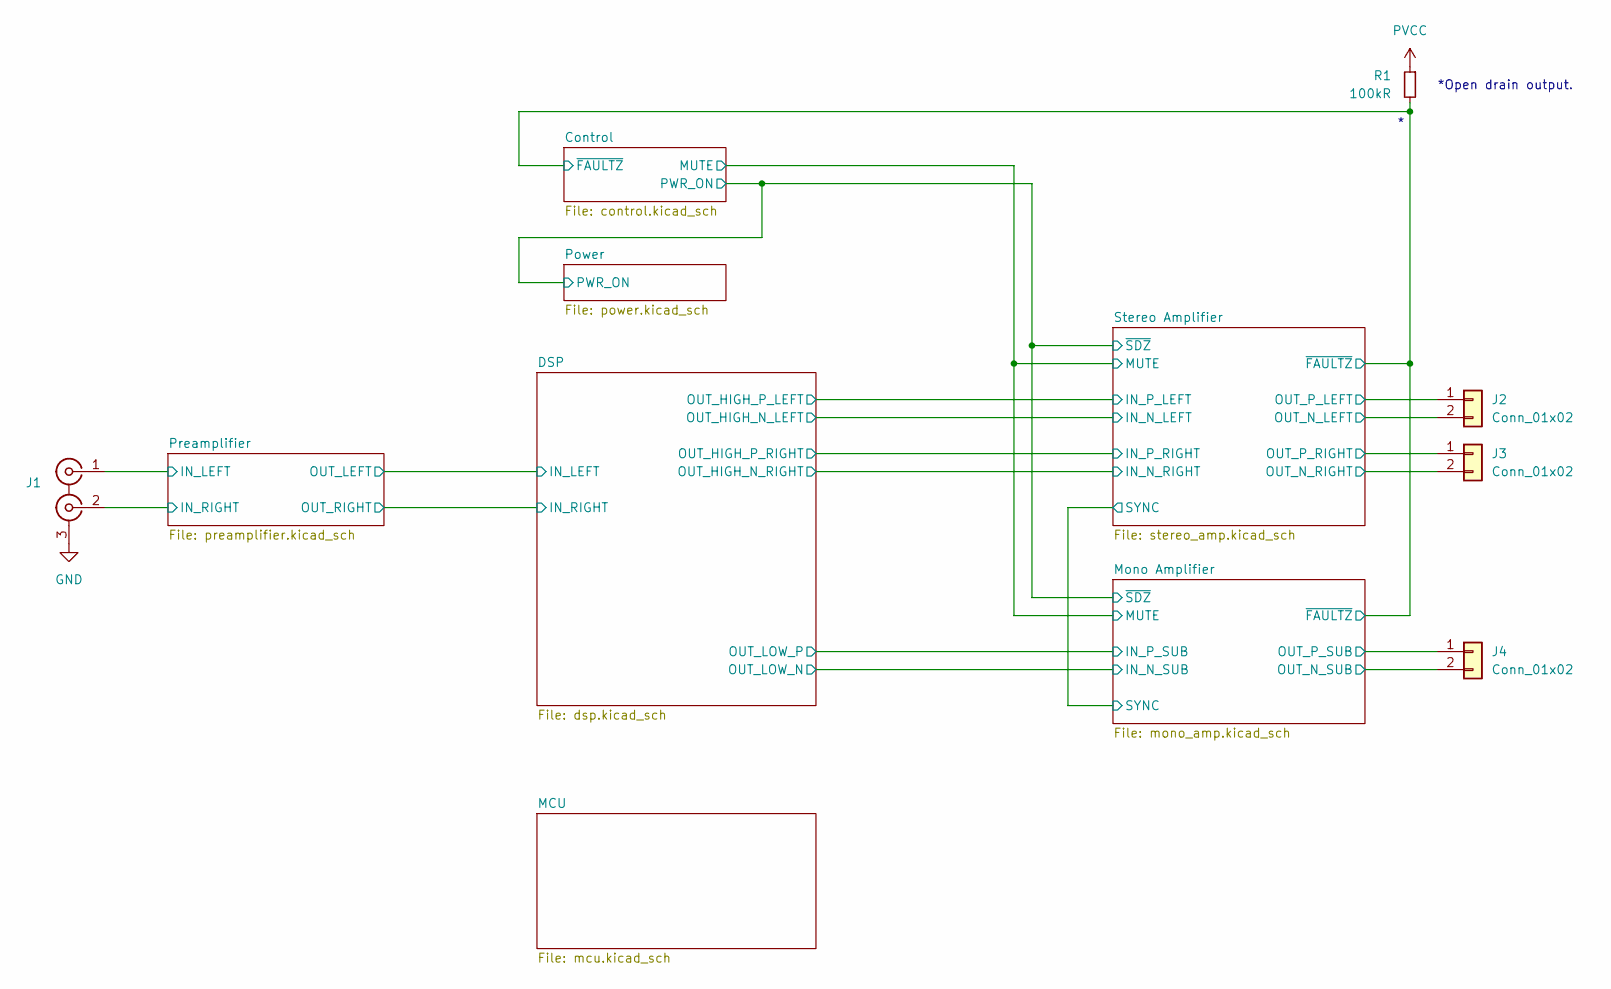
[picture p10: schematic AudioAmplifier.kicad_sch]

Parts:
J1: Conn_Coaxial_x2
J2, J3, J4: Conn_01x02
R1: 100kR

Connections:
GND: J1.3 (EXT)
IN_LEFT: J1.1 (IN1)
IN_RIGHT: J1.2 (IN2)
OUT_N_LEFT: J2.2
OUT_N_RIGHT: J3.2
OUT_N_SUB: J4.2
OUT_P_LEFT: J2.1
OUT_P_RIGHT: J3.1
OUT_P_SUB: J4.1
PVCC: R1.1
~FAULTZ: R1.2

Notes on the sheet:
*Open drain output.
