nunosousa/AudioAmplifier/electronics/audio-amplifier/control.kicad_sch

## KiCad design electronics/audio-amplifier/control.kicad_sch (2026-10-31)

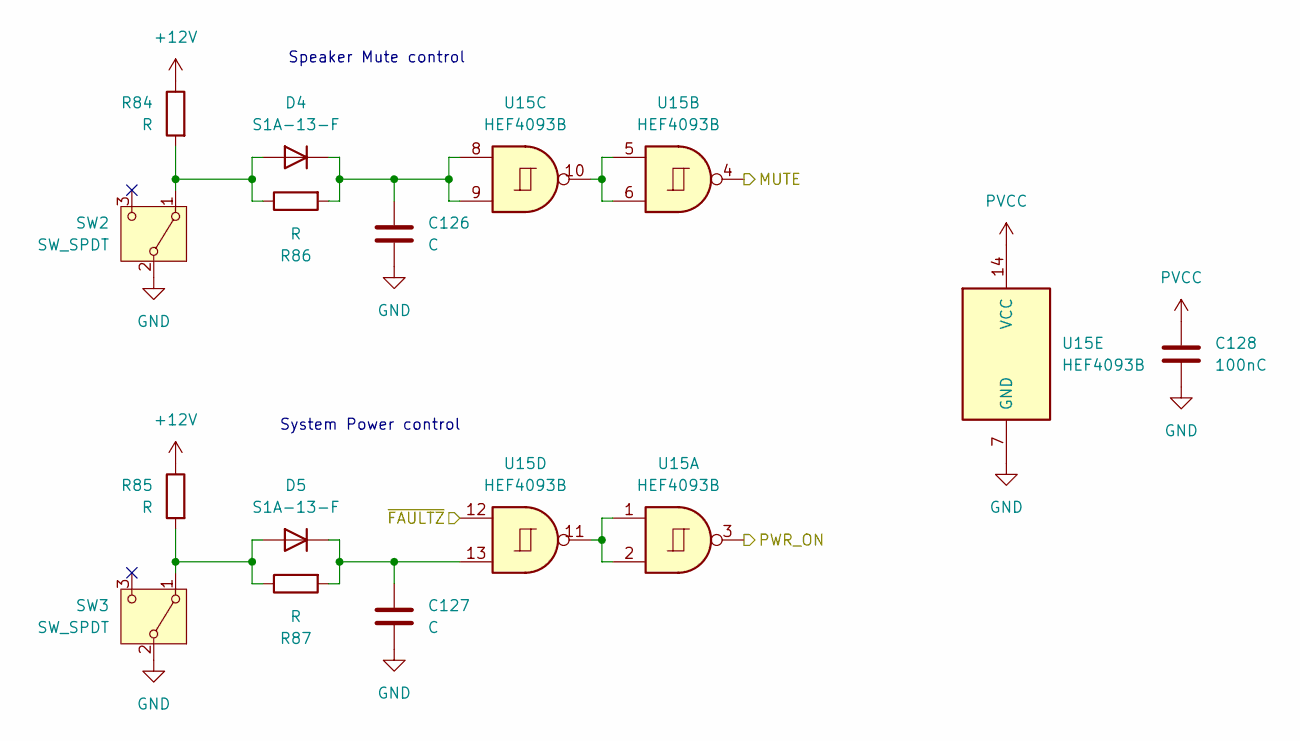
[picture p11: schematic control.kicad_sch]

Parts:
C126, C127: C; C_0805_2012Metric
C128: 100nC; C_0805_2012Metric
D4, D5: S1A-13-F; D_SMA; MPN S1A-13-F
R84, R85, R86, R87: R; R_0805_2012Metric
SW2, SW3: SW_SPDT
U15: HEF4093B; SO-14_3.9x8.65mm_P1.27mm; MPN HEF4093BT,653

Connections:
+12V: R84.1, R85.1
GND: C126.2, C127.2, C128.2, SW2.2 (B), SW3.2 (B), U15.7 (GND)
MUTE: U15.4
unnamed: C126.1, D4.1 (K), R86.2, U15.8, U15.9
unnamed: C127.1, D5.1 (K), R87.2, U15.13
unnamed: D4.2 (A), R84.2, R86.1, SW2.1 (A)
unnamed: D5.2 (A), R85.2, R87.1, SW3.1 (A)
unnamed: U15.1, U15.2, U15.11
unnamed: U15.5, U15.6, U15.10
PVCC: C128.1, U15.14 (VCC)
PWR_ON: U15.3
~FAULTZ: U15.12

Notes on the sheet:
Speaker Mute control
System Power control
