nunosousa/AudioAmplifier/electronics/audio-amplifier/crossover.kicad_sch

## KiCad design electronics/audio-amplifier/crossover.kicad_sch (2026-10-31)

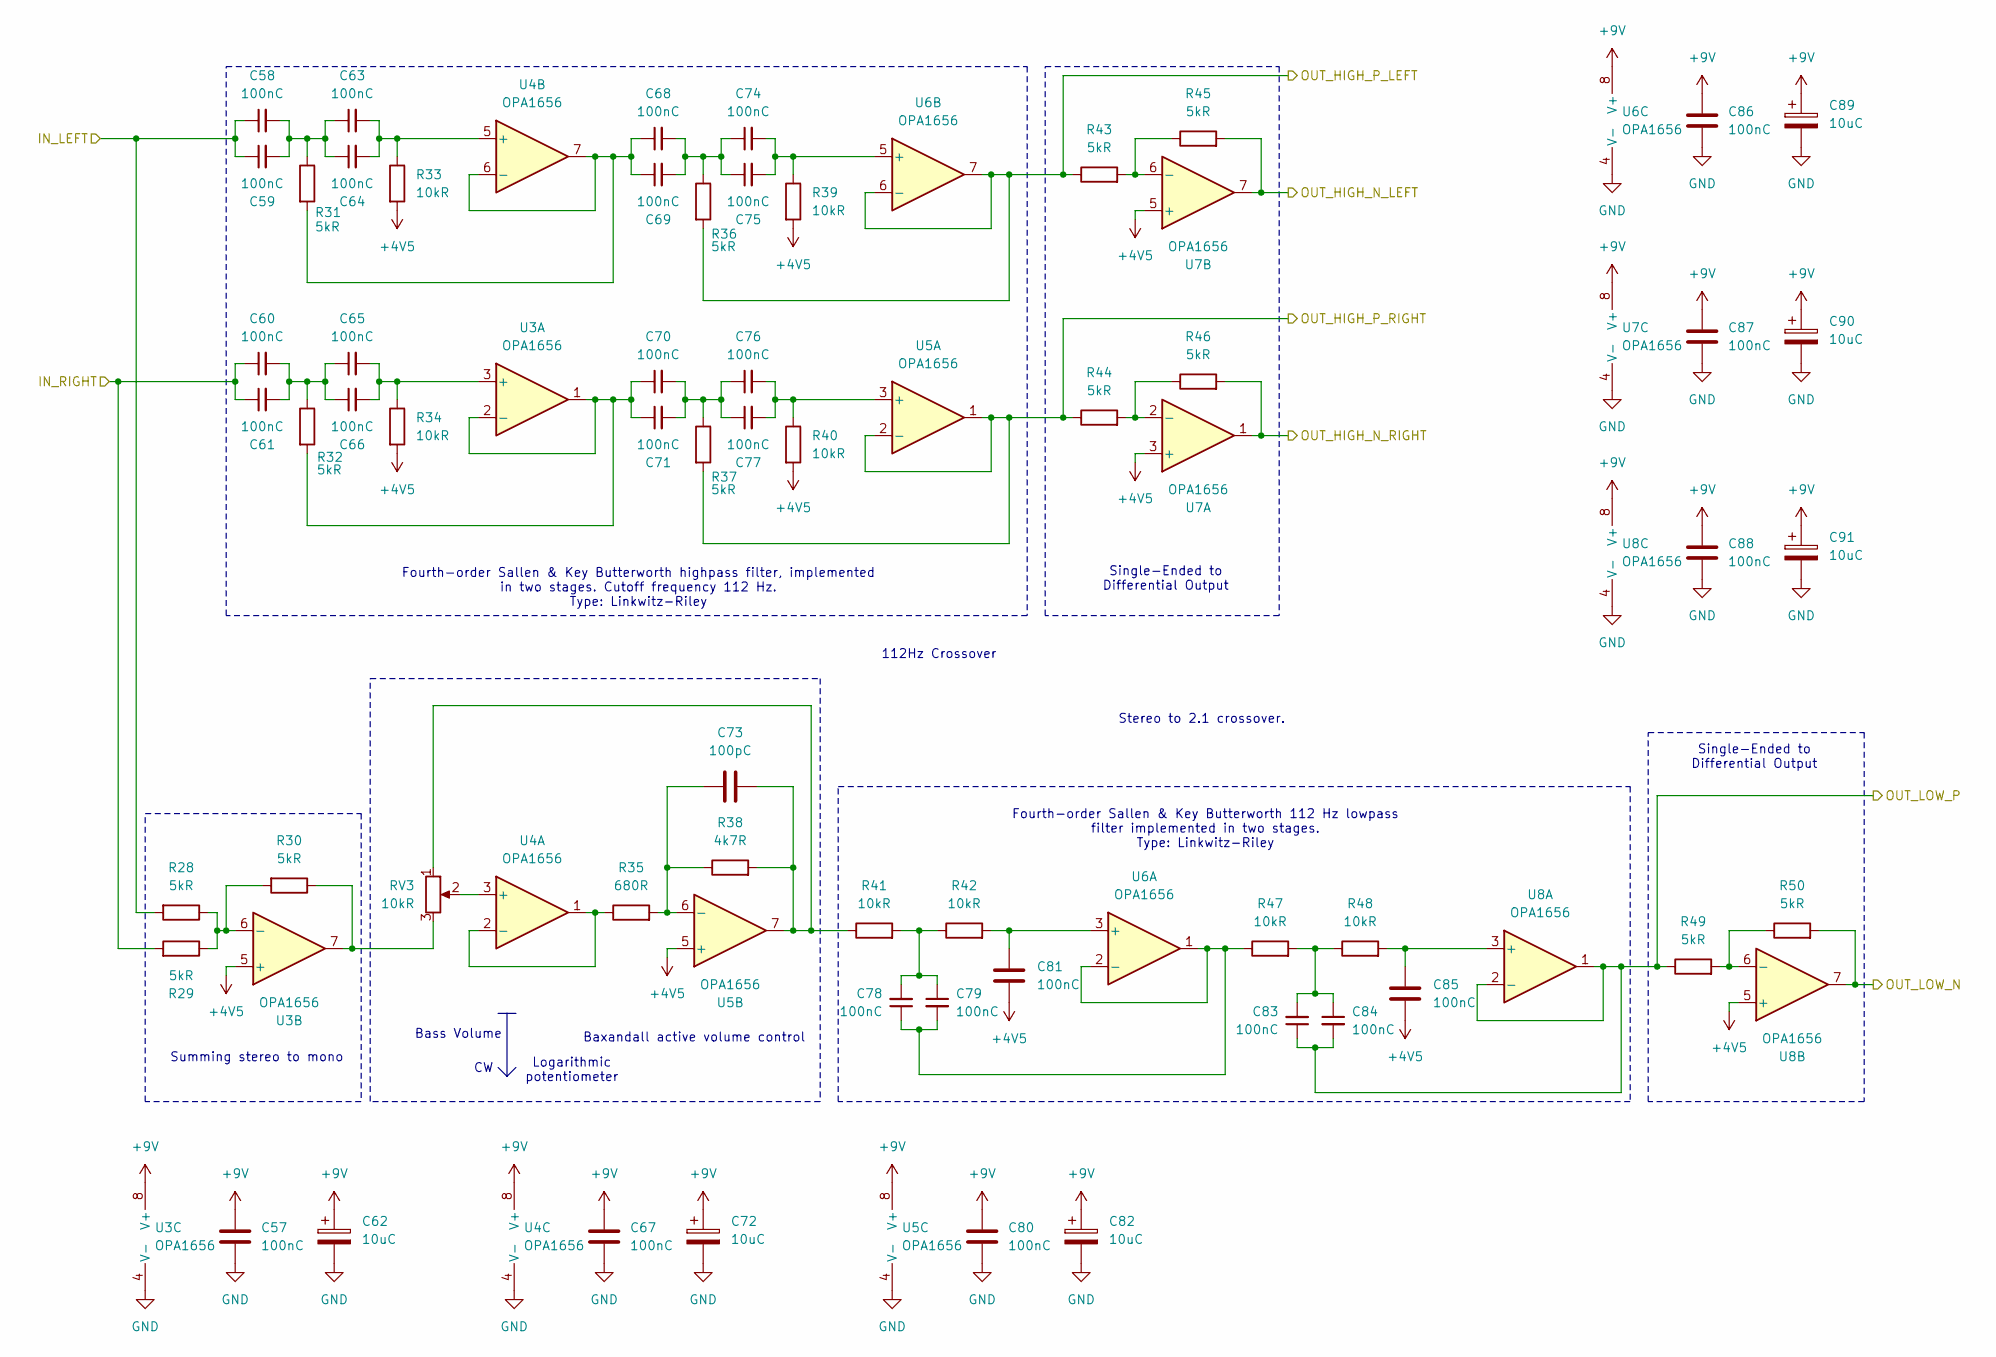
[picture p12: schematic crossover.kicad_sch]

Parts:
C57, C67, C80, C86, C87, C88: 100nC; C_0603_1608Metric; MPN CL10B104KO8NNNC
C58, C59, C60, C61, C63, C64, C65, C66, C68, C69, C70, C71, C74, C75, C76, C77, C78, C79, C81, C83, C84, C85: 100nC; C_1206_3216Metric; MPN GRM31C5C1H104JA01L
C62, C72, C82, C89, C90, C91: 10uC; CP_Elec_4x5.4; MPN UWX1C100MCL1GB
C73: 100pC; C_1206_3216Metric; MPN GRM31A5C3A101JW01D
R28, R29, R30, R31, R32, R36, R37, R43, R44, R45, R46, R49, R50: 5kR; R_0805_2012Metric
R33, R34, R39, R40, R41, R42, R47, R48: 10kR; R_0805_2012Metric
R35: 680R; R_0805_2012Metric
R38: 4k7R; R_0805_2012Metric
RV3: 10kR; Potentiometer_Alps_RK097_Single_Horizontal; MPN RK097111080R
U3, U4, U5, U6, U7, U8: OPA1656; SOIC-8_3.9x4.9mm_P1.27mm; MPN OPA1656IDR

Connections:
+4V5: C81.2, C85.2, R33.2, R34.2, R39.2, R40.2, U3.5 (+), U5.5 (+), U7.3 (+), U7.5 (+), U8.5 (+)
+9V: C57.1, C62.1, C67.1, C72.1, C80.1, C82.1, C86.1, C87.1, C88.1, C89.1, C90.1, C91.1, U3.8 (V+), U4.8 (V+), U5.8 (V+), U6.8 (V+), U7.8 (V+), U8.8 (V+)
GND: C57.2, C62.2, C67.2, C72.2, C80.2, C82.2, C86.2, C87.2, C88.2, C89.2, C90.2, C91.2, U3.4 (V-), U4.4 (V-), U5.4 (V-), U6.4 (V-), U7.4 (V-), U8.4 (V-)
IN_LEFT: C58.1, C59.1, R28.2
IN_RIGHT: C60.1, C61.1, R29.2
unnamed: C58.2, C59.2, C63.1, C64.1, R31.1
unnamed: C60.2, C61.2, C65.1, C66.1, R32.1
unnamed: C63.2, C64.2, R33.1, U4.5 (+)
unnamed: C65.2, C66.2, R34.1, U3.3 (+)
unnamed: C68.1, C69.1, R31.2, U4.6 (-), U4.7
unnamed: C68.2, C69.2, C74.1, C75.1, R36.1
unnamed: C70.1, C71.1, R32.2, U3.1, U3.2 (-)
unnamed: C70.2, C71.2, C76.1, C77.1, R37.1
unnamed: C73.1, R35.2, R38.1, U5.6 (-)
unnamed: C73.2, R38.2, R41.1, RV3.1, U5.7
unnamed: C74.2, C75.2, R39.1, U6.5 (+)
unnamed: C76.2, C77.2, R40.1, U5.3 (+)
unnamed: C78.1, C79.2, R47.1, U6.1, U6.2 (-)
unnamed: C78.2, C79.1, R41.2, R42.1
unnamed: C81.1, R42.2, U6.3 (+)
unnamed: C83.2, C84.1, R47.2, R48.1
unnamed: C85.1, R48.2, U8.3 (+)
unnamed: R28.1, R29.1, R30.2, U3.6 (-)
unnamed: R30.1, RV3.3, U3.7
unnamed: R35.1, U4.1, U4.2 (-)
unnamed: R43.2, R45.1, U7.6 (-)
unnamed: R44.2, R46.1, U7.2 (-)
unnamed: R49.2, R50.1, U8.6 (-)
unnamed: RV3.2, U4.3 (+)
OUT_HIGH_N_LEFT: R45.2, U7.7
OUT_HIGH_N_RIGHT: R46.2, U7.1
OUT_HIGH_P_LEFT: R36.2, R43.1, U6.6 (-), U6.7
OUT_HIGH_P_RIGHT: R37.2, R44.1, U5.1, U5.2 (-)
OUT_LOW_N: R50.2, U8.7
OUT_LOW_P: C83.1, C84.2, R49.1, U8.1, U8.2 (-)

Notes on the sheet:
Fourth-order Sallen & Key Butterworth highpass filter, implemented in two stages. Cutoff frequency 112 Hz. Type: Linkwitz-Riley
Fourth-order Sallen & Key Butterworth 112 Hz lowpass filter implemented in two stages. Type: Linkwitz-Riley
Summing stereo to mono
Bass Volume
Single-Ended to Differential Output
Logarithmic potentiometer
Baxandall active volume control
Stereo to 2.1 crossover.
112Hz Crossover
