nunosousa/AudioAmplifier/electronics/audio-amplifier/dsp.kicad_sch

## KiCad design electronics/audio-amplifier/dsp.kicad_sch (2026-10-31)

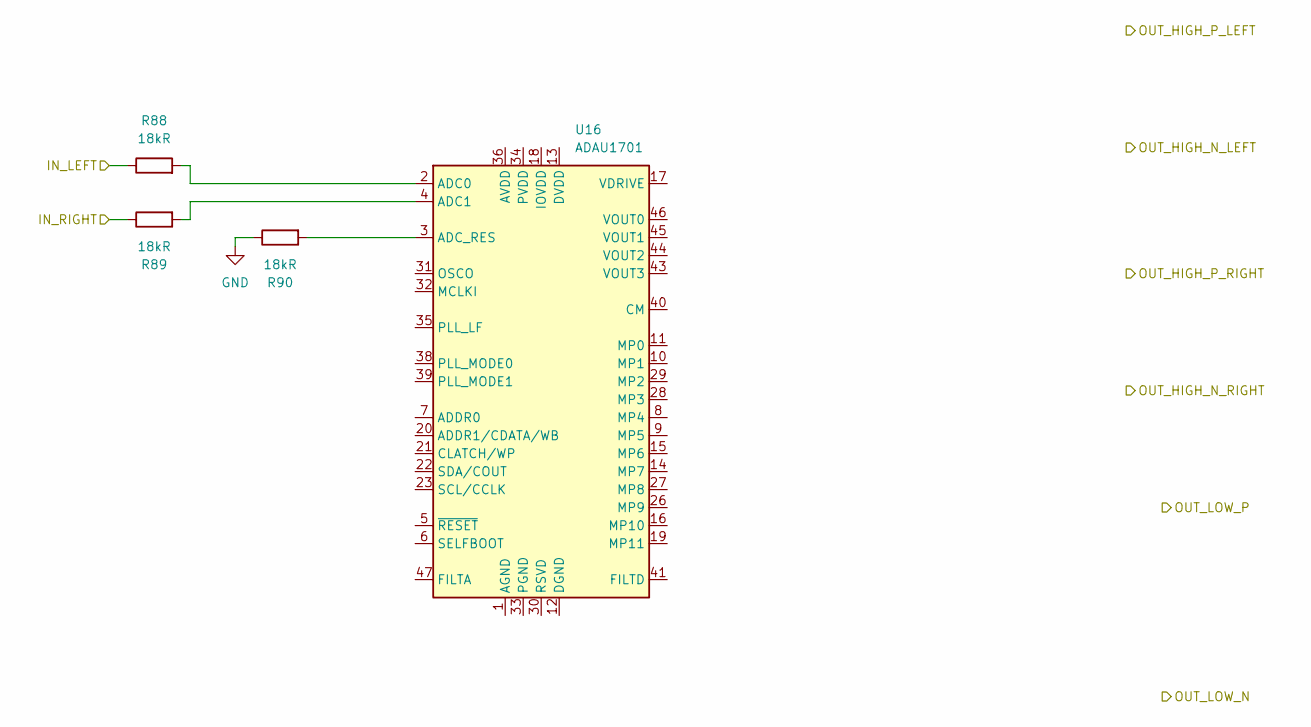
[picture p13: schematic dsp.kicad_sch]

Parts:
R88, R89, R90: 18kR; R_0805_2012Metric
U16: ADAU1701; LQFP-48_7x7mm_P0.5mm

Connections:
GND: R90.1
IN_LEFT: R88.1
IN_RIGHT: R89.1
unnamed: R88.2, U16.2 (ADC0)
unnamed: R89.2, U16.4 (ADC1)
unnamed: R90.2, U16.3 (ADC_RES)
unnamed: U16.1 (AGND), U16.37 (AGND), U16.42 (AGND)
unnamed: U16.12 (DGND), U16.25 (DGND)
unnamed: U16.13 (DVDD), U16.24 (DVDD)
unnamed: U16.36 (AVDD), U16.48 (AVDD)
