nunosousa/AudioAmplifier/electronics/audio-amplifier/headphone_amp.kicad_sch

## KiCad design electronics/audio-amplifier/headphone_amp.kicad_sch (2024-08-15)

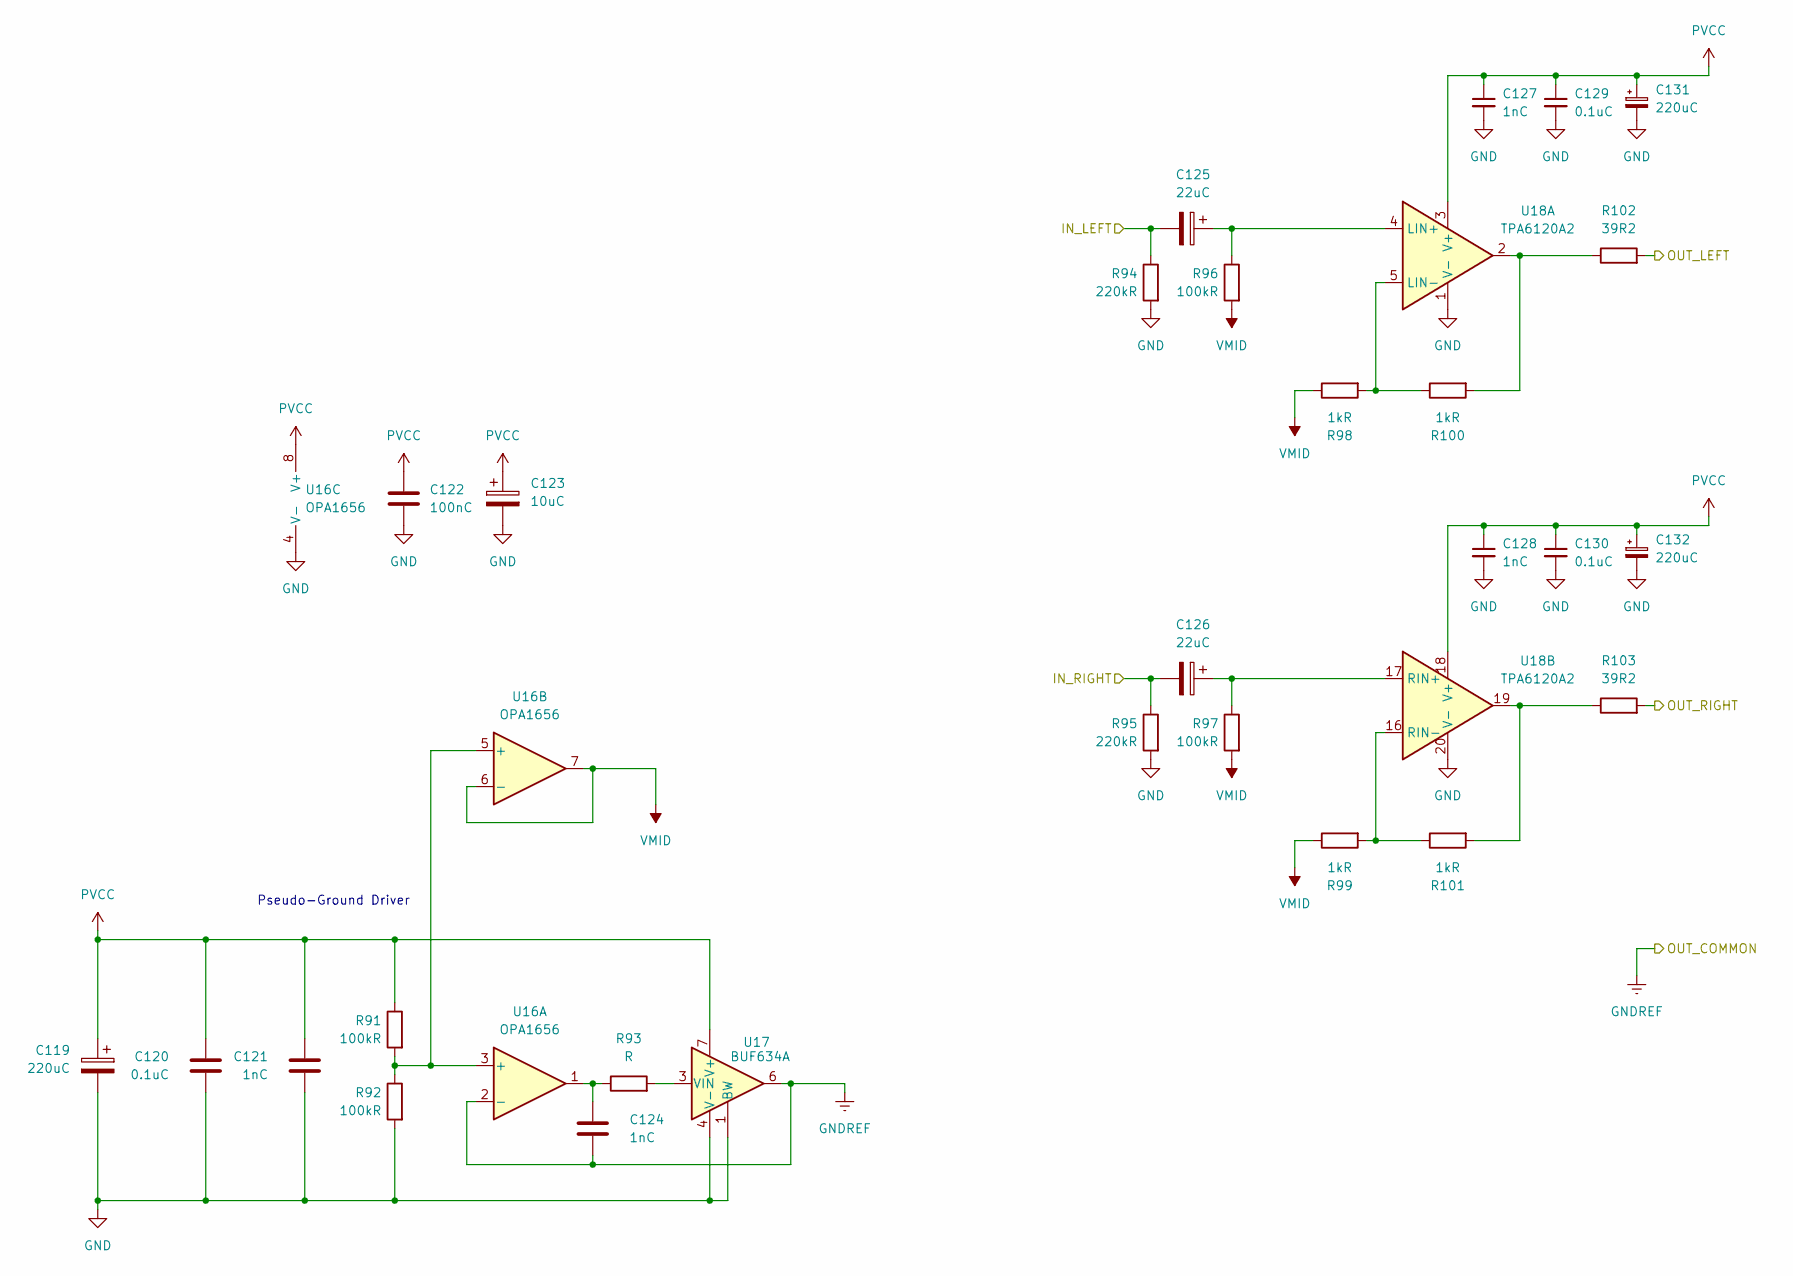
[picture p14: schematic headphone_amp.kicad_sch]

Parts:
C119, C131, C132: 220uC
C120, C129, C130: 0.1uC
C121, C124, C127, C128: 1nC
C122: 100nC; C_0603_1608Metric; MPN CL10B104KO8NNNC
C123: 10uC; CP_Elec_4x5.4; MPN UWX1C100MCL1GB
C125, C126: 22uC; CP_Elec_5x5.4; MPN UWX1C220MCL1GB
R91, R92, R96, R97: 100kR; R_0805_2012Metric; MPN RC0805JR-07100KL
R93: R
R94, R95: 220kR; R_0805_2012Metric; MPN RC0805JR-07220KL
R98, R99, R100, R101: 1kR; R_0805_2012Metric
R102, R103: 39R2; R_0805_2012Metric
U16: OPA1656; SOIC-8_3.9x4.9mm_P1.27mm; MPN OPA1656IDR
U17: BUF634A; SOIC-8_3.9x4.9mm_P1.27mm
U18: TPA6120A2; SO-20-1EP_7.52x12.825mm_P1.27mm_EP6.045x12.09mm_Mask3.56x4.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; MPN TPA6120A2DWPR

Connections:
GND: C119.2, C120.2, C121.2, C122.2, C123.2, C127.2, C128.2, C129.2, C130.2, C131.2, C132.2, R92.2, R94.2, R95.2, U16.4 (V-), U17.1 (BW), U17.4 (V-), U18.1 (V-), U18.20 (V-)
GNDREF: C124.2, U16.2 (-), U17.6
IN_LEFT: C125.2, R94.1
IN_RIGHT: C126.2, R95.1
unnamed: C124.1, R93.1, U16.1
unnamed: C125.1, R96.1, U18.4 (LIN+)
unnamed: C126.1, R97.1, U18.17 (RIN+)
unnamed: R91.2, R92.1, U16.3 (+), U16.5 (+)
unnamed: R93.2, U17.3 (VIN)
unnamed: R98.2, R100.1, U18.5 (LIN-)
unnamed: R100.2, R102.1, U18.2
unnamed: R99.2, R101.1, U18.16 (RIN-)
unnamed: R101.2, R103.1, U18.19
unnamed: U17.2 (NC), U17.5 (NC), U17.8 (NC)
unnamed: U18.6 (NC), U18.7 (NC)
unnamed: U18.8 (NC), U18.9 (NC), U18.10 (NC)
unnamed: U18.11 (NC), U18.12 (NC), U18.13 (NC), U18.14 (NC), U18.15 (NC)
OUT_LEFT: R102.2
OUT_RIGHT: R103.2
PVCC: C119.1, C120.1, C121.1, C122.1, C123.1, C127.1, C128.1, C129.1, C130.1, C131.1, C132.1, R91.1, U16.8 (V+), U17.7 (V+), U18.3 (V+), U18.18 (V+)
VMID: R96.2, R97.2, R98.1, R99.1, U16.6 (-), U16.7

Notes on the sheet:
Pseudo-Ground Driver
