nunosousa/AudioAmplifier/electronics/audio-amplifier/mono_amp.kicad_sch

## KiCad design electronics/audio-amplifier/mono_amp.kicad_sch (2026-11-09, an earlier design)

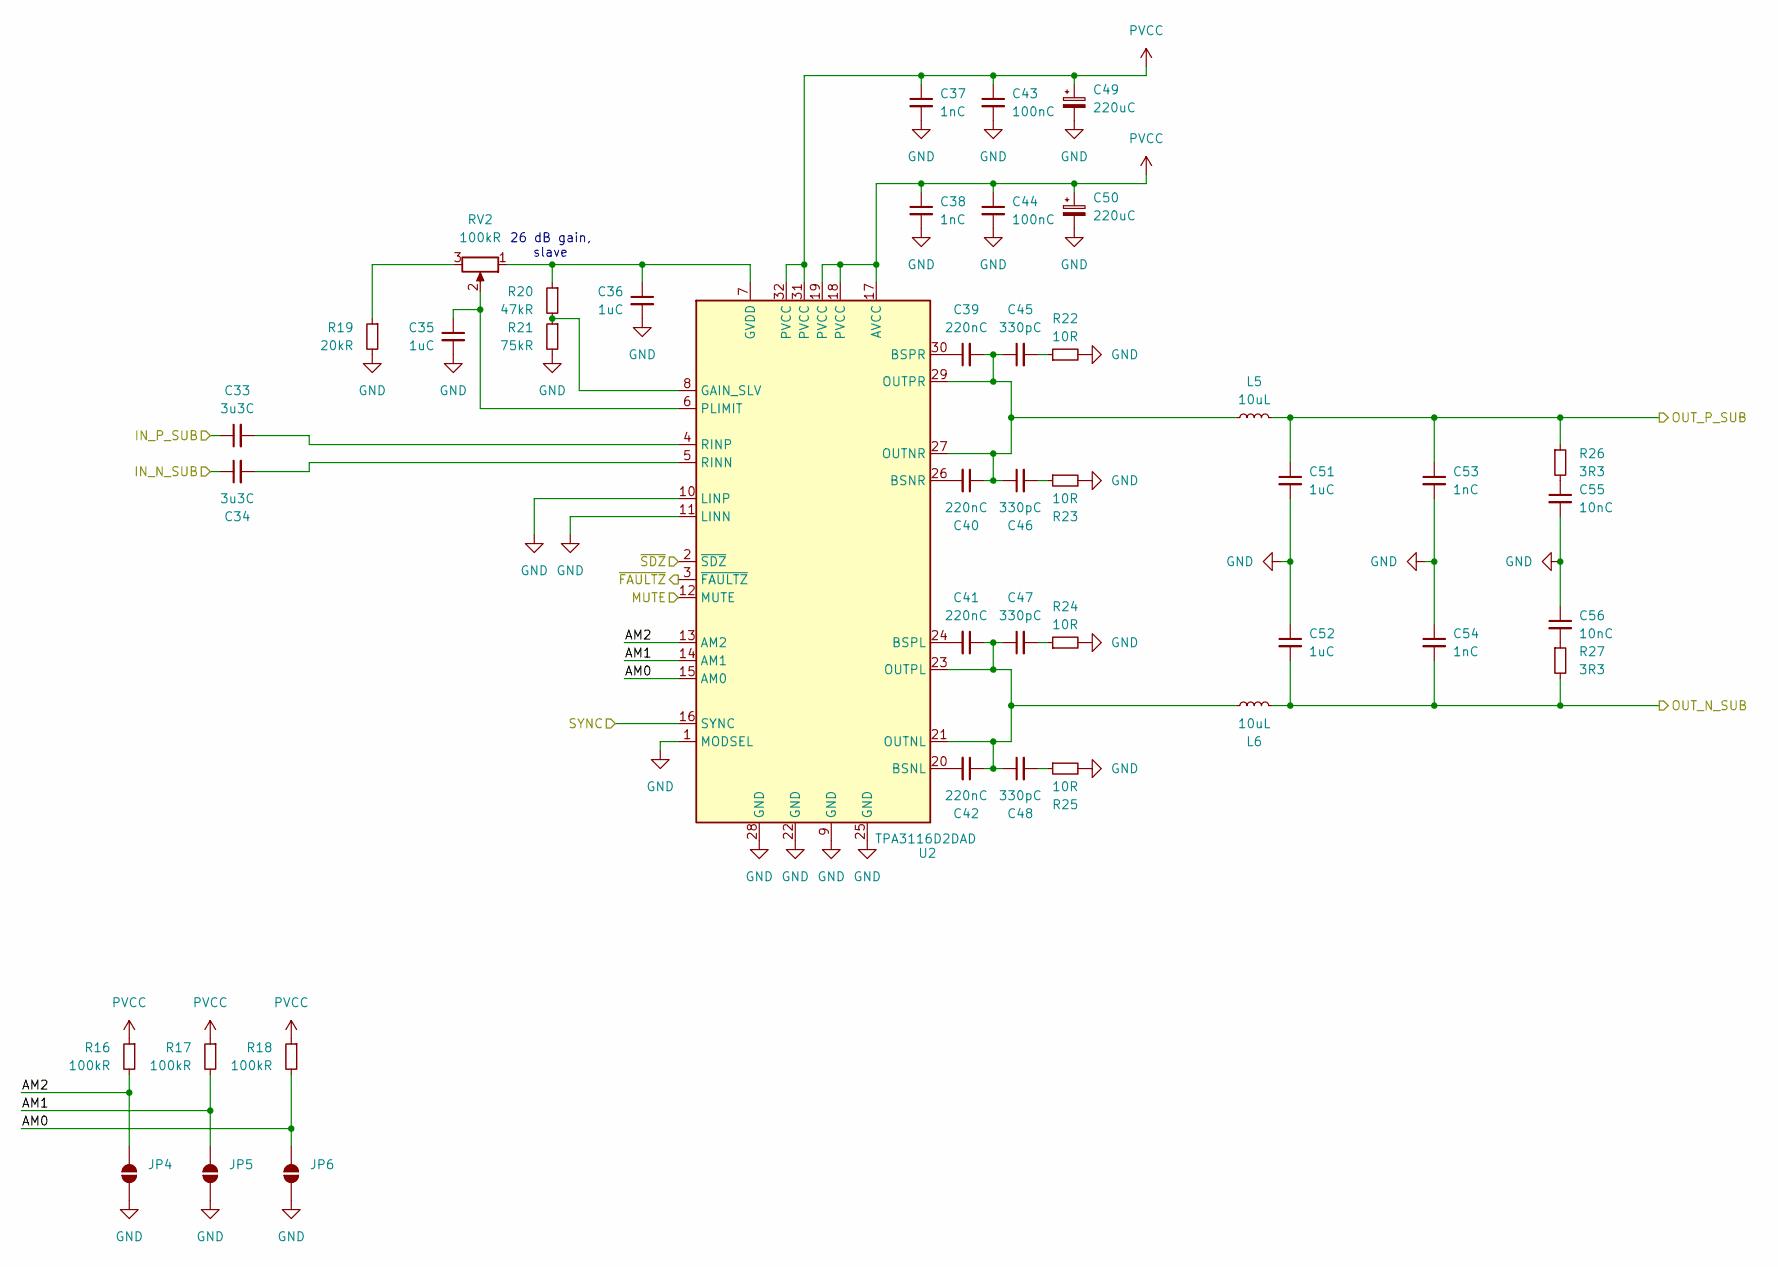
[picture p15: schematic mono_amp.kicad_sch]

Parts:
C33, C34: 3u3C; C_Rect_L31.5mm_W11.0mm_P27.50mm_MKS4; MPN MEF335K250D03
C35, C36: 1uC; C_1206_3216Metric; MPN CC1206KKX7R0BB105
C37, C38, C53, C54: 1nC; C_0805_2012Metric
C39, C40, C41, C42: 220nC; C_0805_2012Metric
C43, C44: 100nC; C_0805_2012Metric
C45, C46, C47, C48: 330pC; C_0805_2012Metric
C49, C50: 220uC
C51, C52: 1uC; C_Rect_L18.0mm_W7.0mm_P15.00mm_FKS3_FKP3; MPN ECQE2105KF
C55, C56: 10nC; C_0805_2012Metric
JP4, JP5, JP6: SolderJumper_2_Open; SolderJumper-2_P1.3mm_Open_TrianglePad1.0x1.5mm
L5, L6: 10uL; L_TaiTech_TMPC1265_13.5x12.5mm; MPN TMPC1265HP-100MG-D
R16, R17, R18: 100kR; R_0805_2012Metric
R19: 20kR; R_0805_2012Metric
R20: 47kR; R_0805_2012Metric
R21: 75kR; R_0805_2012Metric
R22, R23, R24, R25: 10R; R_0805_2012Metric
R26, R27: 3R3; R_0805_2012Metric
RV2: 100kR; Potentiometer_Bourns_3314G_Vertical; MPN 3314G-1-104E
U2: TPA3116D2DAD; TSSOP-32_6.1x11mm_P0.65mm; MPN TPA3116D2DADR

Connections:
AM0: JP6.2 (B), R18.2, U2.15 (AM0)
AM1: JP5.2 (B), R17.2, U2.14 (AM1)
AM2: JP4.2 (B), R16.2, U2.13 (AM2)
GND: C35.2, C36.2, C37.2, C38.2, C43.2, C44.2, C49.2, C50.2, C51.2, C52.1, C53.2, C54.1, C55.2, C56.1, JP4.1 (A), JP5.1 (A), JP6.1 (A), R19.2, R21.2, R22.2, R23.2, R24.2, R25.2, U2.1 (MODSEL), U2.9 (GND), U2.10 (LINP), U2.11 (LINN), U2.22 (GND), U2.25 (GND), U2.28 (GND)
IN_N_SUB: C34.1
IN_P_SUB: C33.1
MUTE: U2.12 (MUTE)
unnamed: C33.2, U2.4 (RINP)
unnamed: C34.2, U2.5 (RINN)
unnamed: C35.1, RV2.2, U2.6 (PLIMIT)
unnamed: C36.1, R20.1, RV2.1, U2.7 (GVDD)
unnamed: C39.1, U2.30 (BSPR)
unnamed: C39.2, C40.1, C45.1, C46.1, L5.1, U2.27 (OUTNR), U2.29 (OUTPR)
unnamed: C40.2, U2.26 (BSNR)
unnamed: C41.1, C42.1, C47.1, C48.1, L6.2, U2.21 (OUTNL), U2.23 (OUTPL)
unnamed: C41.2, U2.24 (BSPL)
unnamed: C42.2, U2.20 (BSNL)
unnamed: C45.2, R22.1
unnamed: C46.2, R23.1
unnamed: C47.2, R24.1
unnamed: C48.2, R25.1
unnamed: C55.1, R26.2
unnamed: C56.2, R27.1
unnamed: R19.1, RV2.3
unnamed: R20.2, R21.1, U2.8 (GAIN_SLV)
OUT_N_SUB: C52.2, C54.2, L6.1, R27.2
OUT_P_SUB: C51.1, C53.1, L5.2, R26.1
PVCC: C37.1, C38.1, C43.1, C44.1, C49.1, C50.1, R16.1, R17.1, R18.1, U2.17 (AVCC), U2.18 (PVCC), U2.19 (PVCC), U2.31 (PVCC), U2.32 (PVCC)
SYNC: U2.16 (SYNC)
~FAULTZ: U2.3 (~FAULTZ)
~SDZ: U2.2 (~SDZ)

Notes on the sheet:
26 dB gain, slave
