nunosousa/AudioAmplifier/electronics/audio-amplifier/power.kicad_sch

## KiCad design electronics/audio-amplifier/power.kicad_sch (2026-11-09, an earlier design)

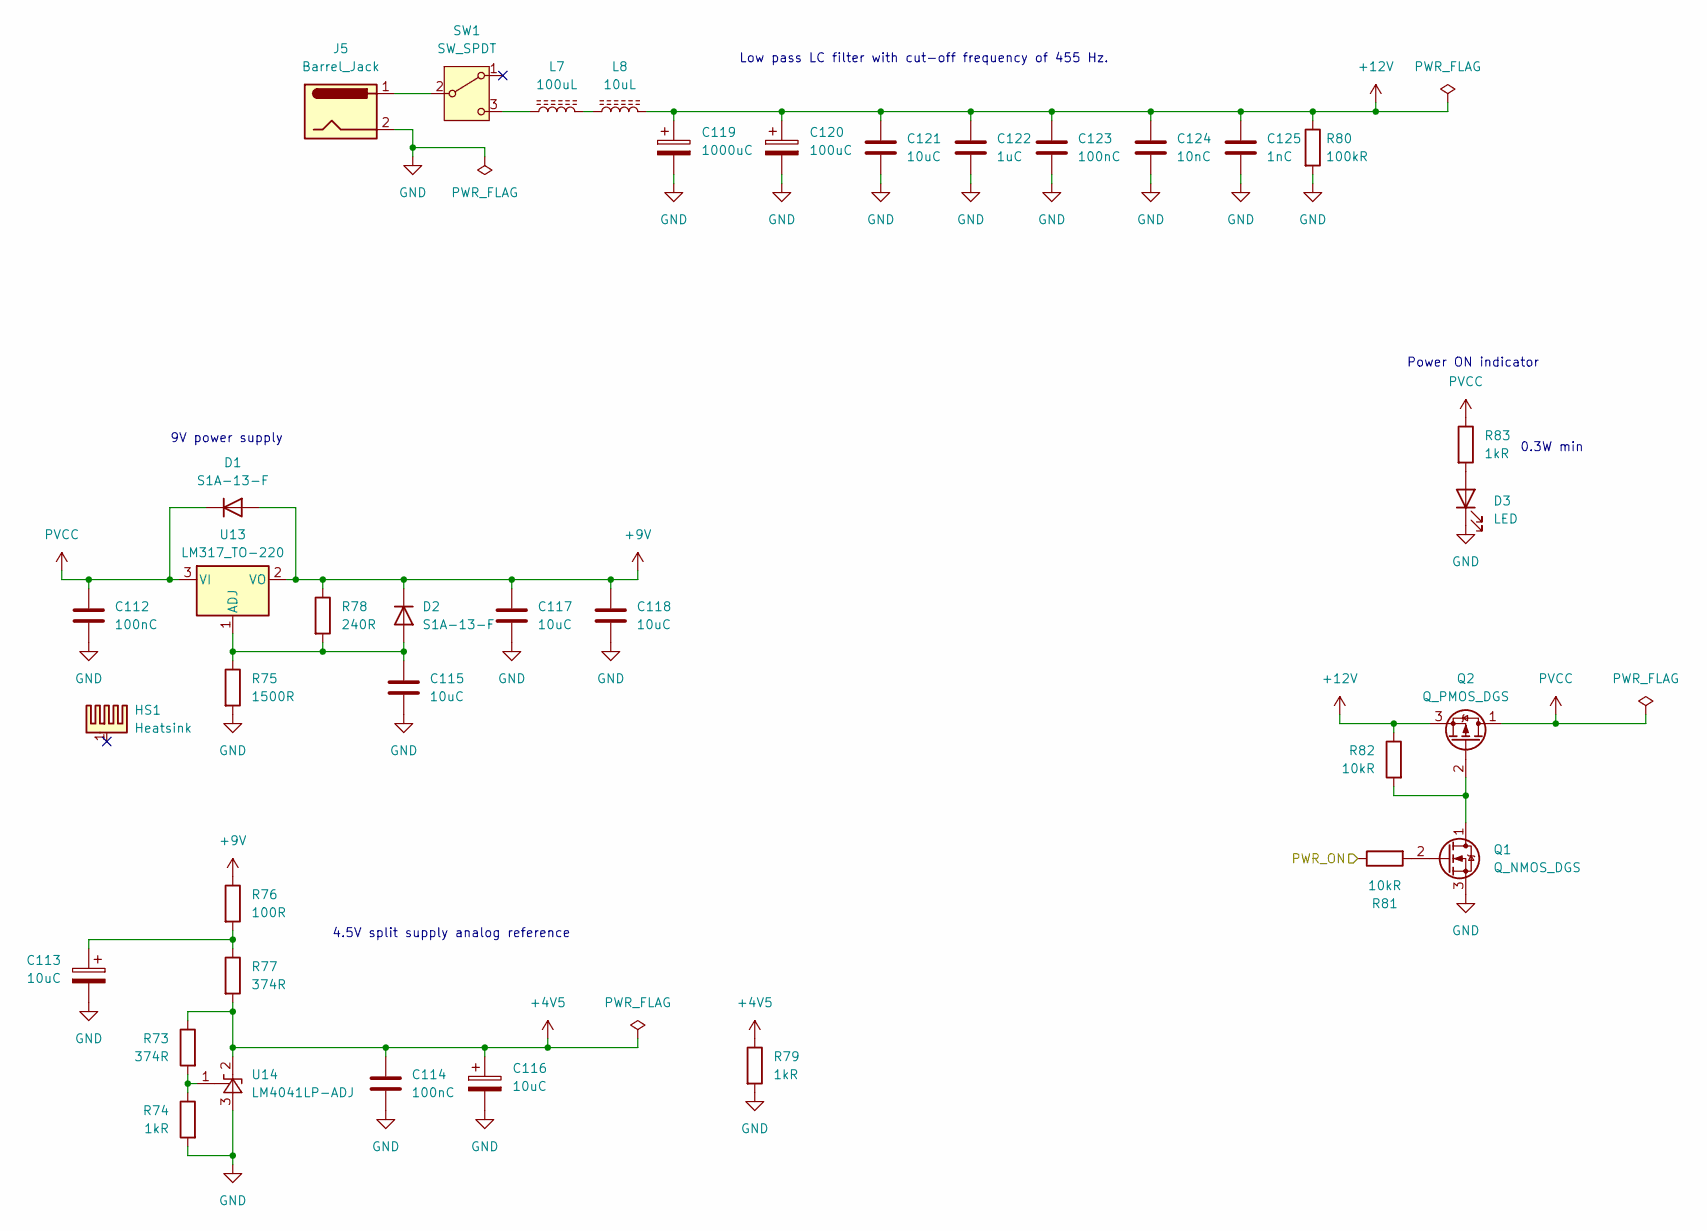
[picture p16: schematic power.kicad_sch]

Parts:
C112, C123: 100nC; C_1206_3216Metric; MPN CC1206KRX7R9BB104
C113, C116: 10uC; CP_Elec_4x5.4; MPN UWX1C100MCL1GB
C114: 100nC; C_0603_1608Metric; MPN CL10B104KO8NNNC
C115, C117, C118, C121: 10uC; C_1206_3216Metric; MPN CL31A106KBHNNNE
C119: 1000uC; CP_Elec_10x10.5; MPN EEEFT1E102UP
C120: 100uC; CP_Elec_8x10; MPN UWT1H101MNL1GS
C122: 1uC; C_1206_3216Metric; MPN CC1206KKX7R0BB105
C124: 10nC; C_1206_3216Metric; MPN CC1206KKX7RCBB103
C125: 1nC; C_1206_3216Metric; MPN CC1206KKX7RDBB102
D1, D2: S1A-13-F; D_SMA; MPN S1A-13-F
D3: LED; LED_D5.0mm; MPN 333-2SURD/S530-A3
HS1: Heatsink; Heatsink_Fischer_SK104-STC-STIC_35x13mm_2xDrill2.5mm
J5: Barrel_Jack
L7: 100uL; MPN TMPC1707HP-101MG-D
L8: 10uL; L_TaiTech_TMPC1265_13.5x12.5mm; MPN TMPC1265HP-100MG-D
Q1: Q_NMOS_DGS
Q2: Q_PMOS_DGS
R73, R77: 374R; R_0805_2012Metric; MPN PTFR0805B374RP9
R74, R79: 1kR; R_0805_2012Metric; MPN RT0805BRD071KL
R75: 1500R; R_0805_2012Metric; MPN RC0805FR-071K5L
R76: 100R; R_0805_2012Metric; MPN RT0805FRD07100RL
R78: 240R; R_0805_2012Metric; MPN RC0805FR-07240RL
R80: 100kR; R_1210_3225Metric; MPN RC0805FR-07100KL
R81, R82: 10kR; R_0805_2012Metric
R83: 1kR; R_1210_3225Metric; MPN 1210W2F1001T5E
SW1: SW_SPDT
U13: LM317_TO-220; TO-220-3_Vertical; MPN LM317KCS
U14: LM4041LP-ADJ; SOT-23-3; MPN LM4041DIDBZT

Connections:
+4V5: C114.1, C116.1, R73.1, R77.2, R79.1, U14.2 (K)
+9V: C117.1, C118.1, D1.2 (A), D2.1 (K), R76.1, R78.1, U13.2 (VO)
+12V: C119.1, C120.1, C121.1, C122.1, C123.1, C124.1, C125.1, L8.2, Q2.3 (S), R80.1, R82.1
GND: C112.2, C113.2, C114.2, C115.2, C116.2, C117.2, C118.2, C119.2, C120.2, C121.2, C122.2, C123.2, C124.2, C125.2, D3.1 (K), J5.2, Q1.3 (S), R74.2, R75.2, R79.2, R80.2, U14.3 (A)
unnamed: C113.1, R76.2, R77.1
unnamed: C115.1, D2.2 (A), R75.1, R78.2, U13.1 (ADJ)
unnamed: D3.2 (A), R83.2
unnamed: J5.1, SW1.2 (B)
unnamed: L7.1, SW1.3 (C)
unnamed: L7.2, L8.1
unnamed: Q1.1 (D), Q2.2 (G), R82.2
unnamed: Q1.2 (G), R81.2
unnamed: R73.2, R74.1, U14.1 (FB)
PVCC: C112.1, D1.1 (K), Q2.1 (D), R83.1, U13.3 (VI)
PWR_ON: R81.1

Notes on the sheet:
4.5V split supply analog reference
Low pass LC filter with cut-off frequency of 455 Hz.
0.3W min
9V power supply
Power ON indicator
