nunosousa/AudioAmplifier/electronics/audio-amplifier/preamplifier.kicad_sch

## KiCad design electronics/audio-amplifier/preamplifier.kicad_sch (2026-11-09, an earlier design)

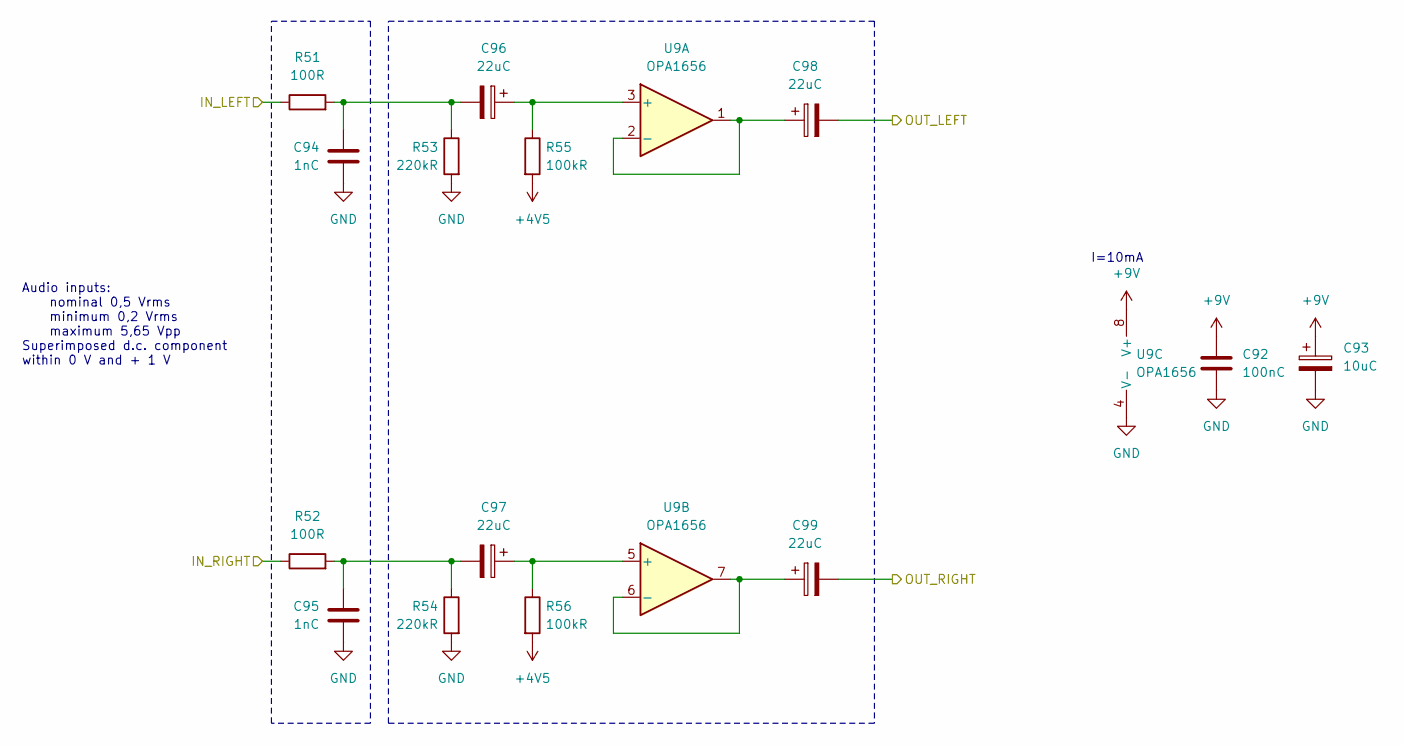
[picture p17: schematic preamplifier.kicad_sch]

Parts:
C92: 100nC; C_0603_1608Metric; MPN CL10B104KO8NNNC
C93: 10uC; CP_Elec_4x5.4; MPN UWX1C100MCL1GB
C94, C95: 1nC; C_0805_2012Metric; MPN CC0805JRNPO9BN102
C96, C97, C98, C99: 22uC; CP_Elec_5x5.4; MPN UWX1C220MCL1GB
R51, R52: 100R; R_0805_2012Metric; MPN RT0805FRD07100RL
R53, R54: 220kR; R_0805_2012Metric; MPN RC0805JR-07220KL
R55, R56: 100kR; R_0805_2012Metric; MPN RC0805JR-07100KL
U9: OPA1656; SOIC-8_3.9x4.9mm_P1.27mm; MPN OPA1656IDR

Connections:
+4V5: R55.2, R56.2
+9V: C92.1, C93.1, U9.8 (V+)
GND: C92.2, C93.2, C94.2, C95.2, R53.2, R54.2, U9.4 (V-)
IN_LEFT: R51.1
IN_RIGHT: R52.1
unnamed: C94.1, C96.2, R51.2, R53.1
unnamed: C95.1, C97.2, R52.2, R54.1
unnamed: C96.1, R55.1, U9.3 (+)
unnamed: C97.1, R56.1, U9.5 (+)
unnamed: C98.1, U9.1, U9.2 (-)
unnamed: C99.1, U9.6 (-), U9.7
OUT_LEFT: C98.2
OUT_RIGHT: C99.2

Notes on the sheet:
I=10mA
Audio inputs: nominal 0,5 Vrms minimum 0,2 Vrms maximum 5,65 Vpp Superimposed d.c. component within 0 V and + 1 V
