nunosousa/AudioAmplifier/electronics/audio-amplifier/stereo_amp.kicad_sch

## KiCad design electronics/audio-amplifier/stereo_amp.kicad_sch (2026-11-09, an earlier design)

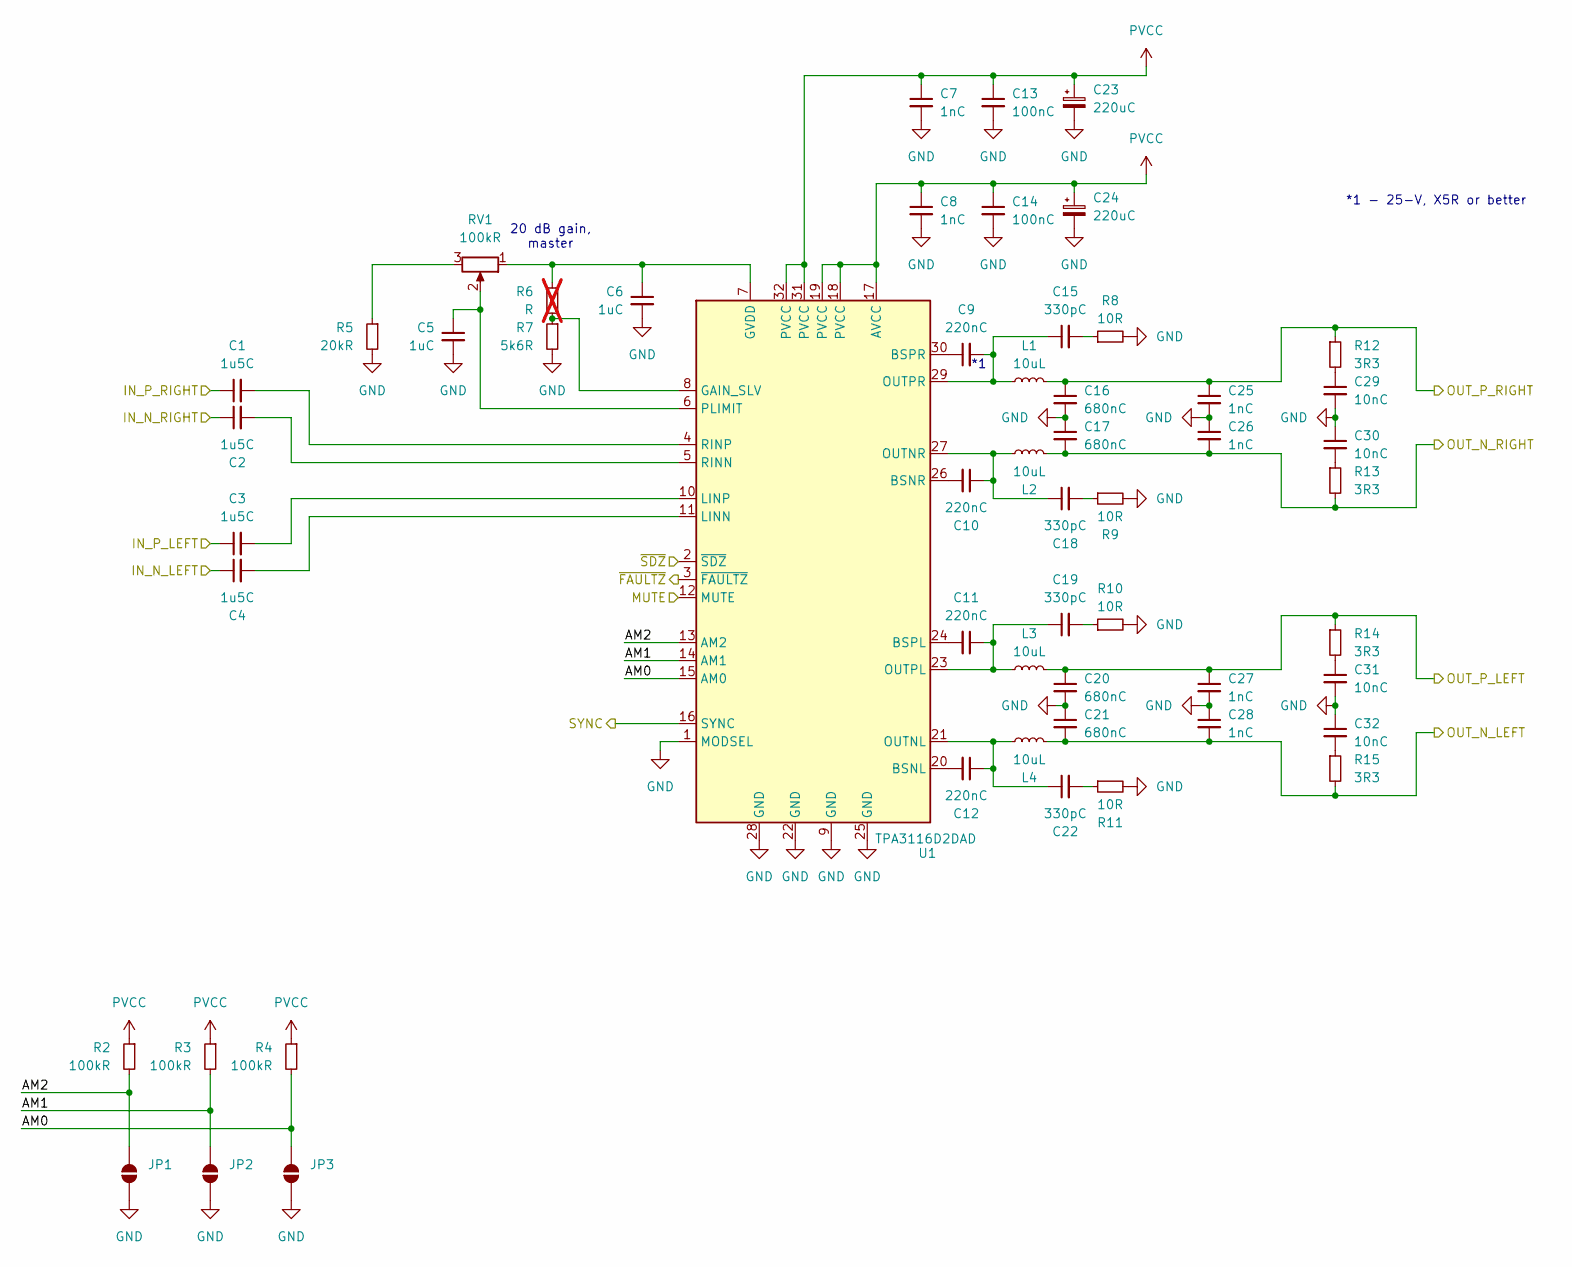
[picture p18: schematic stereo_amp.kicad_sch]

Parts:
C1, C2, C3, C4: 1u5C; C_Rect_L7.5mm_W6.5mm_P5.00mm; MPN B32529C0155K189
C5, C6: 1uC; C_1206_3216Metric; MPN CC1206KKX7R0BB105
C7, C8, C25, C26, C27, C28: 1nC; C_0805_2012Metric
C9, C10, C11, C12: 220nC; C_0805_2012Metric
C13, C14: 100nC; C_0805_2012Metric
C15, C18, C19, C22: 330pC; C_0805_2012Metric
C16, C17, C20, C21: 680nC; C_Rect_L11.5mm_W5.6mm_P10.00mm_MKT; MPN ECQE1684JF
C23, C24: 220uC
C29, C30, C31, C32: 10nC; C_0805_2012Metric
JP1, JP2, JP3: SolderJumper_2_Open; SolderJumper-2_P1.3mm_Open_TrianglePad1.0x1.5mm
L1, L2, L3, L4: 10uL; L_TaiTech_TMPC1265_13.5x12.5mm; MPN TMPC1265HP-100MG-D
R2, R3, R4: 100kR; R_0805_2012Metric
R5: 20kR; R_0805_2012Metric
R6: R; R_0805_2012Metric; not fitted
R7: 5k6R; R_0805_2012Metric
R8, R9, R10, R11: 10R; R_0805_2012Metric
R12, R13, R14, R15: 3R3; R_0805_2012Metric
RV1: 100kR; Potentiometer_Bourns_3314G_Vertical; MPN 3314G-1-104E
U1: TPA3116D2DAD; TSSOP-32_6.1x11mm_P0.65mm; MPN TPA3116D2DADR

Connections:
AM0: JP3.2 (B), R4.2, U1.15 (AM0)
AM1: JP2.2 (B), R3.2, U1.14 (AM1)
AM2: JP1.2 (B), R2.2, U1.13 (AM2)
GND: C5.2, C6.2, C7.2, C8.2, C13.2, C14.2, C16.2, C17.1, C20.2, C21.1, C23.2, C24.2, C25.2, C26.1, C27.2, C28.1, C29.2, C30.1, C31.2, C32.1, JP1.1 (A), JP2.1 (A), JP3.1 (A), R5.2, R7.2, R8.2, R9.2, R10.2, R11.2, U1.1 (MODSEL), U1.9 (GND), U1.22 (GND), U1.25 (GND), U1.28 (GND)
IN_N_LEFT: C4.1
IN_N_RIGHT: C2.1
IN_P_LEFT: C3.1
IN_P_RIGHT: C1.1
MUTE: U1.12 (MUTE)
unnamed: C1.2, U1.4 (RINP)
unnamed: C2.2, U1.5 (RINN)
unnamed: C3.2, U1.10 (LINP)
unnamed: C4.2, U1.11 (LINN)
unnamed: C5.1, RV1.2, U1.6 (PLIMIT)
unnamed: C6.1, R6.1, RV1.1, U1.7 (GVDD)
unnamed: C9.1, U1.30 (BSPR)
unnamed: C10.1, C18.1, L2.2, U1.27 (OUTNR)
unnamed: C10.2, U1.26 (BSNR)
unnamed: C11.1, C19.1, L3.1, U1.23 (OUTPL)
unnamed: C11.2, U1.24 (BSPL)
unnamed: C12.1, C22.1, L4.2, U1.21 (OUTNL)
unnamed: C12.2, U1.20 (BSNL)
unnamed: C9.2, C15.1, L1.1, U1.29 (OUTPR)
unnamed: C15.2, R8.1
unnamed: C18.2, R9.1
unnamed: C19.2, R10.1
unnamed: C22.2, R11.1
unnamed: C29.1, R12.2
unnamed: C30.2, R13.1
unnamed: C31.1, R14.2
unnamed: C32.2, R15.1
unnamed: R5.1, RV1.3
unnamed: R6.2, R7.1, U1.8 (GAIN_SLV)
OUT_N_LEFT: C21.2, C28.2, L4.1, R15.2
OUT_N_RIGHT: C17.2, C26.2, L2.1, R13.2
OUT_P_LEFT: C20.1, C27.1, L3.2, R14.1
OUT_P_RIGHT: C16.1, C25.1, L1.2, R12.1
PVCC: C7.1, C8.1, C13.1, C14.1, C23.1, C24.1, R2.1, R3.1, R4.1, U1.17 (AVCC), U1.18 (PVCC), U1.19 (PVCC), U1.31 (PVCC), U1.32 (PVCC)
SYNC: U1.16 (SYNC)
~FAULTZ: U1.3 (~FAULTZ)
~SDZ: U1.2 (~SDZ)

Notes on the sheet:
20 dB gain, master
*1 - 25-V, X5R or better
