nunosousa/AudioAmplifier/electronics/audio-amplifier/dsp/ADAU1701_IC_1_PARAM.h

/*
 * File:           C:\GitHub\AudioAmplifier\ECAD\AudioAmplifier\SigmaStudio\ADAU1701_IC_1_PARAM.h
 *
 * Created:        Thursday, March 20, 2025 9:57:59 PM
 * Description:    ADAU1701:IC 1 parameter RAM definitions.
 *
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
 * This software may only be used to program products purchased from
 * Analog Devices for incorporation by you into audio products that
 * are intended for resale to audio product end users. This software
 * may not be distributed whole or in any part to third parties.
 *
 * Copyright ©2025 Analog Devices, Inc. All rights reserved.
 */
#ifndef __ADAU1701_IC_1_PARAM_H__
#define __ADAU1701_IC_1_PARAM_H__


/* Module DCB1 - DC Blocking*/
#define MOD_DCB1_COUNT                                 2
#define MOD_DCB1_DEVICE                                "IC1"
#define MOD_DCB1_ALG0_DCBLOCKALGDOUBLEPREC1POLE_ADDR   0
#define MOD_DCB1_ALG0_DCBLOCKALGDOUBLEPREC1POLE_FIXPT  0x007FFCB9
#define MOD_DCB1_ALG0_DCBLOCKALGDOUBLEPREC1POLE_VALUE  SIGMASTUDIOTYPE_FIXPOINT_CONVERT(0.9999)
#define MOD_DCB1_ALG0_DCBLOCKALGDOUBLEPREC1POLE_TYPE   SIGMASTUDIOTYPE_FIXPOINT
#define MOD_DCB1_ALG1_DCBLOCKALGDOUBLEPREC2POLE_ADDR   1
#define MOD_DCB1_ALG1_DCBLOCKALGDOUBLEPREC2POLE_FIXPT  0x007FFCB9
#define MOD_DCB1_ALG1_DCBLOCKALGDOUBLEPREC2POLE_VALUE  SIGMASTUDIOTYPE_FIXPOINT_CONVERT(0.9999)
#define MOD_DCB1_ALG1_DCBLOCKALGDOUBLEPREC2POLE_TYPE   SIGMASTUDIOTYPE_FIXPOINT

/* Module Gen Filter1 - General (2nd order)*/
#define MOD_GENFILTER1_COUNT                           5
#define MOD_GENFILTER1_DEVICE                          "IC1"
#define MOD_GENFILTER1_ALG0_STAGE0_B0_ADDR             2
#define MOD_GENFILTER1_ALG0_STAGE0_B0_FIXPT            0xFF841F29
#define MOD_GENFILTER1_ALG0_STAGE0_B0_VALUE            SIGMASTUDIOTYPE_FIXPOINT_CONVERT(-0.967799088930799)
#define MOD_GENFILTER1_ALG0_STAGE0_B0_TYPE             SIGMASTUDIOTYPE_FIXPOINT
#define MOD_GENFILTER1_ALG0_STAGE0_B1_ADDR             3
#define MOD_GENFILTER1_ALG0_STAGE0_B1_FIXPT            0x00F7E3A8
#define MOD_GENFILTER1_ALG0_STAGE0_B1_VALUE            SIGMASTUDIOTYPE_FIXPOINT_CONVERT(1.93663507653529)
#define MOD_GENFILTER1_ALG0_STAGE0_B1_TYPE             SIGMASTUDIOTYPE_FIXPOINT
#define MOD_GENFILTER1_ALG0_STAGE0_B2_ADDR             4
#define MOD_GENFILTER1_ALG0_STAGE0_B2_FIXPT            0xFF841F29
#define MOD_GENFILTER1_ALG0_STAGE0_B2_VALUE            SIGMASTUDIOTYPE_FIXPOINT_CONVERT(-0.967799088930799)
#define MOD_GENFILTER1_ALG0_STAGE0_B2_TYPE             SIGMASTUDIOTYPE_FIXPOINT
#define MOD_GENFILTER1_ALG0_STAGE0_A1_ADDR             5
#define MOD_GENFILTER1_ALG0_STAGE0_A1_FIXPT            0x00F7C1AE
#define MOD_GENFILTER1_ALG0_STAGE0_A1_VALUE            SIGMASTUDIOTYPE_FIXPOINT_CONVERT(1.9355981778616)
#define MOD_GENFILTER1_ALG0_STAGE0_A1_TYPE             SIGMASTUDIOTYPE_FIXPOINT
#define MOD_GENFILTER1_ALG0_STAGE0_A2_ADDR             6
#define MOD_GENFILTER1_ALG0_STAGE0_A2_FIXPT            0xFF881C58
#define MOD_GENFILTER1_ALG0_STAGE0_A2_VALUE            SIGMASTUDIOTYPE_FIXPOINT_CONVERT(-0.936635076535285)
#define MOD_GENFILTER1_ALG0_STAGE0_A2_TYPE             SIGMASTUDIOTYPE_FIXPOINT

/* Module Crossover1 - Crossover*/
#define MOD_CROSSOVER1_COUNT                           164
#define MOD_CROSSOVER1_DEVICE                          "IC1"
#define MOD_CROSSOVER1_ALG0_CROSSOVERFILTER2WAYALGDP1LOWINVERT_ADDR 7
#define MOD_CROSSOVER1_ALG0_CROSSOVERFILTER2WAYALGDP1LOWINVERT_FIXPT 0x00800000
#define MOD_CROSSOVER1_ALG0_CROSSOVERFILTER2WAYALGDP1LOWINVERT_VALUE SIGMASTUDIOTYPE_FIXPOINT_CONVERT(1)
#define MOD_CROSSOVER1_ALG0_CROSSOVERFILTER2WAYALGDP1LOWINVERT_TYPE SIGMASTUDIOTYPE_FIXPOINT
#define MOD_CROSSOVER1_ALG0_CROSSOVERFILTER2WAYALGDP1LOWINVERT_ADDR 7
#define MOD_CROSSOVER1_ALG0_CROSSOVERFILTER2WAYALGDP1LOWINVERT_FIXPT 0x00800000
#define MOD_CROSSOVER1_ALG0_CROSSOVERFILTER2WAYALGDP1LOWINVERT_VALUE SIGMASTUDIOTYPE_FIXPOINT_CONVERT(1)
#define MOD_CROSSOVER1_ALG0_CROSSOVERFILTER2WAYALGDP1LOWINVERT_TYPE SIGMASTUDIOTYPE_FIXPOINT
#define MOD_CROSSOVER1_ALG0_LOW_FILT1_PARAMB0_ADDR     8
#define MOD_CROSSOVER1_ALG0_LOW_FILT1_PARAMB0_FIXPT    0x0000008B
#define MOD_CROSSOVER1_ALG0_LOW_FILT1_PARAMB0_VALUE    SIGMASTUDIOTYPE_FIXPOINT_CONVERT(1.66808172206787E-05)
#define MOD_CROSSOVER1_ALG0_LOW_FILT1_PARAMB0_TYPE     SIGMASTUDIOTYPE_FIXPOINT
#define MOD_CROSSOVER1_ALG0_LOW_FILT1_PARAMB0_ADDR     8
#define MOD_CROSSOVER1_ALG0_LOW_FILT1_PARAMB0_FIXPT    0x0000008B
#define MOD_CROSSOVER1_ALG0_LOW_FILT1_PARAMB0_VALUE    SIGMASTUDIOTYPE_FIXPOINT_CONVERT(1.66808172206787E-05)
#define MOD_CROSSOVER1_ALG0_LOW_FILT1_PARAMB0_TYPE     SIGMASTUDIOTYPE_FIXPOINT
#define MOD_CROSSOVER1_ALG0_LOW_FILT1_PARAMB1_ADDR     9
#define MOD_CROSSOVER1_ALG0_LOW_FILT1_PARAMB1_FIXPT    0x00000117
#define MOD_CROSSOVER1_ALG0_LOW_FILT1_PARAMB1_VALUE    SIGMASTUDIOTYPE_FIXPOINT_CONVERT(3.33616344413575E-05)
#define MOD_CROSSOVER1_ALG0_LOW_FILT1_PARAMB1_TYPE     SIGMASTUDIOTYPE_FIXPOINT
#define MOD_CROSSOVER1_ALG0_LOW_FILT1_PARAMB1_ADDR     9
#define MOD_CROSSOVER1_ALG0_LOW_FILT1_PARAMB1_FIXPT    0x00000117
#define MOD_CROSSOVER1_ALG0_LOW_FILT1_PARAMB1_VALUE    SIGMASTUDIOTYPE_FIXPOINT_CONVERT(3.33616344413575E-05)
#define MOD_CROSSOVER1_ALG0_LOW_FILT1_PARAMB1_TYPE     SIGMASTUDIOTYPE_FIXPOINT
#define MOD_CROSSOVER1_ALG0_LOW_FILT1_PARAMA1_ADDR     10
#define MOD_CROSSOVER1_ALG0_LOW_FILT1_PARAMA1_FIXPT    0x00FF3146
#define MOD_CROSSOVER1_ALG0_LOW_FILT1_PARAMA1_VALUE    SIGMASTUDIOTYPE_FIXPOINT_CONVERT(1.99369124602851)
#define MOD_CROSSOVER1_ALG0_LOW_FILT1_PARAMA1_TYPE     SIGMASTUDIOTYPE_FIXPOINT
#define MOD_CROSSOVER1_ALG0_LOW_FILT1_PARAMA1_ADDR     10
#define MOD_CROSSOVER1_ALG0_LOW_FILT1_PARAMA1_FIXPT    0x00FF3146
#define MOD_CROSSOVER1_ALG0_LOW_FILT1_PARAMA1_VALUE    SIGMASTUDIOTYPE_FIXPOINT_CONVERT(1.99369124602851)
#define MOD_CROSSOVER1_ALG0_LOW_FILT1_PARAMA1_TYPE     SIGMASTUDIOTYPE_FIXPOINT
#define MOD_CROSSOVER1_ALG0_LOW_FILT1_PARAMB2_ADDR     11
#define MOD_CROSSOVER1_ALG0_LOW_FILT1_PARAMB2_FIXPT    0x0000008B
#define MOD_CROSSOVER1_ALG0_LOW_FILT1_PARAMB2_VALUE    SIGMASTUDIOTYPE_FIXPOINT_CONVERT(1.66808172206787E-05)
#define MOD_CROSSOVER1_ALG0_LOW_FILT1_PARAMB2_TYPE     SIGMASTUDIOTYPE_FIXPOINT
#define MOD_CROSSOVER1_ALG0_LOW_FILT1_PARAMB2_ADDR     11
#define MOD_CROSSOVER1_ALG0_LOW_FILT1_PARAMB2_FIXPT    0x0000008B
#define MOD_CROSSOVER1_ALG0_LOW_FILT1_PARAMB2_VALUE    SIGMASTUDIOTYPE_FIXPOINT_CONVERT(1.66808172206787E-05)
#define MOD_CROSSOVER1_ALG0_LOW_FILT1_PARAMB2_TYPE     SIGMASTUDIOTYPE_FIXPOINT
#define MOD_CROSSOVER1_ALG0_LOW_FILT1_PARAMA2_ADDR     12
#define MOD_CROSSOVER1_ALG0_LOW_FILT1_PARAMA2_FIXPT    0xFF80CC8A
#define MOD_CROSSOVER1_ALG0_LOW_FILT1_PARAMA2_VALUE    SIGMASTUDIOTYPE_FIXPOINT_CONVERT(-0.993757969297397)
#define MOD_CROSSOVER1_ALG0_LOW_FILT1_PARAMA2_TYPE     SIGMASTUDIOTYPE_FIXPOINT
#define MOD_CROSSOVER1_ALG0_LOW_FILT1_PARAMA2_ADDR     12
#define MOD_CROSSOVER1_ALG0_LOW_FILT1_PARAMA2_FIXPT    0xFF80CC8A
#define MOD_CROSSOVER1_ALG0_LOW_FILT1_PARAMA2_VALUE    SIGMASTUDIOTYPE_FIXPOINT_CONVERT(-0.993757969297397)
#define MOD_CROSSOVER1_ALG0_LOW_FILT1_PARAMA2_TYPE     SIGMASTUDIOTYPE_FIXPOINT
#define MOD_CROSSOVER1_ALG0_LOW_FILT2_PARAMB0_ADDR     13
#define MOD_CROSSOVER1_ALG0_LOW_FILT2_PARAMB0_FIXPT    0x0000008B
#define MOD_CROSSOVER1_ALG0_LOW_FILT2_PARAMB0_VALUE    SIGMASTUDIOTYPE_FIXPOINT_CONVERT(1.66075152647826E-05)
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
#define MOD_CROSSOVER1_ALG0_LOW_FILT4_PARAMA1_ADDR     25
#define MOD_CROSSOVER1_ALG0_LOW_FILT4_PARAMA1_FIXPT    0x00FE1231
#define MOD_CROSSOVER1_ALG0_LOW_FILT4_PARAMA1_VALUE    SIGMASTUDIOTYPE_FIXPOINT_CONVERT(1.98493019638368)
#define MOD_CROSSOVER1_ALG0_LOW_FILT4_PARAMA1_TYPE     SIGMASTUDIOTYPE_FIXPOINT
#define MOD_CROSSOVER1_ALG0_LOW_FILT4_PARAMA1_ADDR     25
#define MOD_CROSSOVER1_ALG0_LOW_FILT4_PARAMA1_FIXPT    0x00FE1231
#define MOD_CROSSOVER1_ALG0_LOW_FILT4_PARAMA1_VALUE    SIGMASTUDIOTYPE_FIXPOINT_CONVERT(1.98493019638368)
#define MOD_CROSSOVER1_ALG0_LOW_FILT4_PARAMA1_TYPE     SIGMASTUDIOTYPE_FIXPOINT
#define MOD_CROSSOVER1_ALG0_LOW_FILT4_PARAMB2_ADDR     26
#define MOD_CROSSOVER1_ALG0_LOW_FILT4_PARAMB2_FIXPT    0x0000008B
#define MOD_CROSSOVER1_ALG0_LOW_FILT4_PARAMB2_VALUE    SIGMASTUDIOTYPE_FIXPOINT_CONVERT(1.66075152647826E-05)
#define MOD_CROSSOVER1_ALG0_LOW_FILT4_PARAMB2_TYPE     SIGMASTUDIOTYPE_FIXPOINT
#define MOD_CROSSOVER1_ALG0_LOW_FILT4_PARAMB2_ADDR     26
#define MOD_CROSSOVER1_ALG0_LOW_FILT4_PARAMB2_FIXPT    0x0000008B
#define MOD_CROSSOVER1_ALG0_LOW_FILT4_PARAMB2_VALUE    SIGMASTUDIOTYPE_FIXPOINT_CONVERT(1.66075152647826E-05)
#define MOD_CROSSOVER1_ALG0_LOW_FILT4_PARAMB2_TYPE     SIGMASTUDIOTYPE_FIXPOINT
#define MOD_CROSSOVER1_ALG0_LOW_FILT4_PARAMA2_ADDR     27
#define MOD_CROSSOVER1_ALG0_LOW_FILT4_PARAMA2_FIXPT    0xFF81EBA2
#define MOD_CROSSOVER1_ALG0_LOW_FILT4_PARAMA2_VALUE    SIGMASTUDIOTYPE_FIXPOINT_CONVERT(-0.984996626444738)
#define MOD_CROSSOVER1_ALG0_LOW_FILT4_PARAMA2_TYPE     SIGMASTUDIOTYPE_FIXPOINT
#define MOD_CROSSOVER1_ALG0_LOW_FILT4_PARAMA2_ADDR     27
#define MOD_CROSSOVER1_ALG0_LOW_FILT4_PARAMA2_FIXPT    0xFF81EBA2
#define MOD_CROSSOVER1_ALG0_LOW_FILT4_PARAMA2_VALUE    SIGMASTUDIOTYPE_FIXPOINT_CONVERT(-0.984996626444738)
#define MOD_CROSSOVER1_ALG0_LOW_FILT4_PARAMA2_TYPE     SIGMASTUDIOTYPE_FIXPOINT
#define MOD_CROSSOVER1_ALG0_HIGH_FILT1_PARAMB0_ADDR    28
#define MOD_CROSSOVER1_ALG0_HIGH_FILT1_PARAMB0_FIXPT   0x007F992F
#define MOD_CROSSOVER1_ALG0_HIGH_FILT1_PARAMB0_VALUE   SIGMASTUDIOTYPE_FIXPOINT_CONVERT(0.996862303831478)
#define MOD_CROSSOVER1_ALG0_HIGH_FILT1_PARAMB0_TYPE    SIGMASTUDIOTYPE_FIXPOINT
#define MOD_CROSSOVER1_ALG0_HIGH_FILT1_PARAMB0_ADDR    28
#define MOD_CROSSOVER1_ALG0_HIGH_FILT1_PARAMB0_FIXPT   0x007F992F
#define MOD_CROSSOVER1_ALG0_HIGH_FILT1_PARAMB0_VALUE   SIGMASTUDIOTYPE_FIXPOINT_CONVERT(0.996862303831478)
#define MOD_CROSSOVER1_ALG0_HIGH_FILT1_PARAMB0_TYPE    SIGMASTUDIOTYPE_FIXPOINT
#define MOD_CROSSOVER1_ALG0_HIGH_FILT1_PARAMB1_ADDR    29
#define MOD_CROSSOVER1_ALG0_HIGH_FILT1_PARAMB1_FIXPT   0xFF00CDA2
#define MOD_CROSSOVER1_ALG0_HIGH_FILT1_PARAMB1_VALUE   SIGMASTUDIOTYPE_FIXPOINT_CONVERT(-1.99372460766296)
#define MOD_CROSSOVER1_ALG0_HIGH_FILT1_PARAMB1_TYPE    SIGMASTUDIOTYPE_FIXPOINT
#define MOD_CROSSOVER1_ALG0_HIGH_FILT1_PARAMB1_ADDR    29
#define MOD_CROSSOVER1_ALG0_HIGH_FILT1_PARAMB1_FIXPT   0xFF00CDA2
#define MOD_CROSSOVER1_ALG0_HIGH_FILT1_PARAMB1_VALUE   SIGMASTUDIOTYPE_FIXPOINT_CONVERT(-1.99372460766296)
#define MOD_CROSSOVER1_ALG0_HIGH_FILT1_PARAMB1_TYPE    SIGMASTUDIOTYPE_FIXPOINT
#define MOD_CROSSOVER1_ALG0_HIGH_FILT1_PARAMA1_ADDR    30
#define MOD_CROSSOVER1_ALG0_HIGH_FILT1_PARAMA1_FIXPT   0x00FF3146
#define MOD_CROSSOVER1_ALG0_HIGH_FILT1_PARAMA1_VALUE   SIGMASTUDIOTYPE_FIXPOINT_CONVERT(1.99369124602851)
#define MOD_CROSSOVER1_ALG0_HIGH_FILT1_PARAMA1_TYPE    SIGMASTUDIOTYPE_FIXPOINT
#define MOD_CROSSOVER1_ALG0_HIGH_FILT1_PARAMA1_ADDR    30
#define MOD_CROSSOVER1_ALG0_HIGH_FILT1_PARAMA1_FIXPT   0x00FF3146
#define MOD_CROSSOVER1_ALG0_HIGH_FILT1_PARAMA1_VALUE   SIGMASTUDIOTYPE_FIXPOINT_CONVERT(1.99369124602851)
#define MOD_CROSSOVER1_ALG0_HIGH_FILT1_PARAMA1_TYPE    SIGMASTUDIOTYPE_FIXPOINT
#define MOD_CROSSOVER1_ALG0_HIGH_FILT1_PARAMB2_ADDR    31
#define MOD_CROSSOVER1_ALG0_HIGH_FILT1_PARAMB2_FIXPT   0x007F992F
#define MOD_CROSSOVER1_ALG0_HIGH_FILT1_PARAMB2_VALUE   SIGMASTUDIOTYPE_FIXPOINT_CONVERT(0.996862303831478)
#define MOD_CROSSOVER1_ALG0_HIGH_FILT1_PARAMB2_TYPE    SIGMASTUDIOTYPE_FIXPOINT
#define MOD_CROSSOVER1_ALG0_HIGH_FILT1_PARAMB2_ADDR    31
#define MOD_CROSSOVER1_ALG0_HIGH_FILT1_PARAMB2_FIXPT   0x007F992F
#define MOD_CROSSOVER1_ALG0_HIGH_FILT1_PARAMB2_VALUE   SIGMASTUDIOTYPE_FIXPOINT_CONVERT(0.996862303831478)
#define MOD_CROSSOVER1_ALG0_HIGH_FILT1_PARAMB2_TYPE    SIGMASTUDIOTYPE_FIXPOINT
#define MOD_CROSSOVER1_ALG0_HIGH_FILT1_PARAMA2_ADDR    32
#define MOD_CROSSOVER1_ALG0_HIGH_FILT1_PARAMA2_FIXPT   0xFF80CC8A
#define MOD_CROSSOVER1_ALG0_HIGH_FILT1_PARAMA2_VALUE   SIGMASTUDIOTYPE_FIXPOINT_CONVERT(-0.993757969297397)
#define MOD_CROSSOVER1_ALG0_HIGH_FILT1_PARAMA2_TYPE    SIGMASTUDIOTYPE_FIXPOINT
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
#define MOD_CROSSOVER1_ALG1_HIGH_FILT4_PARAMA1_ADDR    86
#define MOD_CROSSOVER1_ALG1_HIGH_FILT4_PARAMA1_FIXPT   0x00FE1231
#define MOD_CROSSOVER1_ALG1_HIGH_FILT4_PARAMA1_VALUE   SIGMASTUDIOTYPE_FIXPOINT_CONVERT(1.98493019638368)
#define MOD_CROSSOVER1_ALG1_HIGH_FILT4_PARAMA1_TYPE    SIGMASTUDIOTYPE_FIXPOINT
#define MOD_CROSSOVER1_ALG1_HIGH_FILT4_PARAMB2_ADDR    87
#define MOD_CROSSOVER1_ALG1_HIGH_FILT4_PARAMB2_FIXPT   0x007F09A3
#define MOD_CROSSOVER1_ALG1_HIGH_FILT4_PARAMB2_VALUE   SIGMASTUDIOTYPE_FIXPOINT_CONVERT(0.992481705707104)
#define MOD_CROSSOVER1_ALG1_HIGH_FILT4_PARAMB2_TYPE    SIGMASTUDIOTYPE_FIXPOINT
#define MOD_CROSSOVER1_ALG1_HIGH_FILT4_PARAMB2_ADDR    87
#define MOD_CROSSOVER1_ALG1_HIGH_FILT4_PARAMB2_FIXPT   0x007F09A3
#define MOD_CROSSOVER1_ALG1_HIGH_FILT4_PARAMB2_VALUE   SIGMASTUDIOTYPE_FIXPOINT_CONVERT(0.992481705707104)
#define MOD_CROSSOVER1_ALG1_HIGH_FILT4_PARAMB2_TYPE    SIGMASTUDIOTYPE_FIXPOINT
#define MOD_CROSSOVER1_ALG1_HIGH_FILT4_PARAMA2_ADDR    88
#define MOD_CROSSOVER1_ALG1_HIGH_FILT4_PARAMA2_FIXPT   0xFF81EBA2
#define MOD_CROSSOVER1_ALG1_HIGH_FILT4_PARAMA2_VALUE   SIGMASTUDIOTYPE_FIXPOINT_CONVERT(-0.984996626444738)
#define MOD_CROSSOVER1_ALG1_HIGH_FILT4_PARAMA2_TYPE    SIGMASTUDIOTYPE_FIXPOINT
#define MOD_CROSSOVER1_ALG1_HIGH_FILT4_PARAMA2_ADDR    88
#define MOD_CROSSOVER1_ALG1_HIGH_FILT4_PARAMA2_FIXPT   0xFF81EBA2
#define MOD_CROSSOVER1_ALG1_HIGH_FILT4_PARAMA2_VALUE   SIGMASTUDIOTYPE_FIXPOINT_CONVERT(-0.984996626444738)
#define MOD_CROSSOVER1_ALG1_HIGH_FILT4_PARAMA2_TYPE    SIGMASTUDIOTYPE_FIXPOINT

/* Module Mg1 - Signal Merger*/
#define MOD_MG1_COUNT                                  1
#define MOD_MG1_DEVICE                                 "IC1"
#define MOD_MG1_SINGLECTRLMIXER19401_ADDR              89
#define MOD_MG1_SINGLECTRLMIXER19401_FIXPT             0x00400000
#define MOD_MG1_SINGLECTRLMIXER19401_VALUE             SIGMASTUDIOTYPE_FIXPOINT_CONVERT(0.5)
#define MOD_MG1_SINGLECTRLMIXER19401_TYPE              SIGMASTUDIOTYPE_FIXPOINT

/* Module SW vol 1 - Single SW slew vol (adjustable)*/
#define MOD_SWVOL1_COUNT                               2
#define MOD_SWVOL1_DEVICE                              "IC1"
#define MOD_SWVOL1_ALG0_TARGET_ADDR                    90
#define MOD_SWVOL1_ALG0_TARGET_FIXPT                   0x00800000
#define MOD_SWVOL1_ALG0_TARGET_VALUE                   SIGMASTUDIOTYPE_FIXPOINT_CONVERT(1)
#define MOD_SWVOL1_ALG0_TARGET_TYPE                    SIGMASTUDIOTYPE_FIXPOINT
#define MOD_SWVOL1_ALG0_STEP_ADDR                      91
#define MOD_SWVOL1_ALG0_STEP_FIXPT                     0x00000800
#define MOD_SWVOL1_ALG0_STEP_VALUE                     SIGMASTUDIOTYPE_FIXPOINT_CONVERT(0.000244140625)
#define MOD_SWVOL1_ALG0_STEP_TYPE                      SIGMASTUDIOTYPE_FIXPOINT

/* Module Inv1 - Signal Invert*/
#define MOD_INV1_COUNT                                 1
#define MOD_INV1_DEVICE                                "IC1"
#define MOD_INV1_EQ1940INVERT1GAIN_ADDR                92
#define MOD_INV1_EQ1940INVERT1GAIN_FIXPT               0x00800000
#define MOD_INV1_EQ1940INVERT1GAIN_VALUE               SIGMASTUDIOTYPE_FIXPOINT_CONVERT(1)
#define MOD_INV1_EQ1940INVERT1GAIN_TYPE                SIGMASTUDIOTYPE_FIXPOINT

/* Module Inv1_2 - Signal Invert*/
#define MOD_INV1_2_COUNT                               1
#define MOD_INV1_2_DEVICE                              "IC1"
#define MOD_INV1_2_EQ1940INVERT2GAIN_ADDR              93
#define MOD_INV1_2_EQ1940INVERT2GAIN_FIXPT             0x00800000
#define MOD_INV1_2_EQ1940INVERT2GAIN_VALUE             SIGMASTUDIOTYPE_FIXPOINT_CONVERT(1)
#define MOD_INV1_2_EQ1940INVERT2GAIN_TYPE              SIGMASTUDIOTYPE_FIXPOINT

/* Module Inv1_3 - Signal Invert*/
#define MOD_INV1_3_COUNT                               1
#define MOD_INV1_3_DEVICE                              "IC1"
#define MOD_INV1_3_EQ1940INVERT3GAIN_ADDR              94
#define MOD_INV1_3_EQ1940INVERT3GAIN_FIXPT             0x00800000
#define MOD_INV1_3_EQ1940INVERT3GAIN_VALUE             SIGMASTUDIOTYPE_FIXPOINT_CONVERT(1)
#define MOD_INV1_3_EQ1940INVERT3GAIN_TYPE              SIGMASTUDIOTYPE_FIXPOINT

#endif
