nunosousa/AudioAmplifier/(commit log)

2024-03-16 Progressed ECAD.
    [mono_amp.kicad_sch, stereo_amp.kicad_sch]
2024-04-14 Progressed ECAD
    [headphone_amp.kicad_sch]
2024-04-23 Update Filter Design.xlsx
    [Filter Design.xlsx]
2025-03-22 Added DSP.
    [ADAU1701.params]
2026-10-31 Replaced analog sections with DSP.
    [AudioAmplifier.kicad_pcb, AudioAmplifier.kicad_sch, control.kicad_sch, crossover.kicad_sch, dsp.kicad_sch, mcu.kicad_sch, mono_amp.kicad_sch, power.kicad_sch]
2026-10-31 Enhance front-panel design and documentation for audio amplifier project
    - Updated DESIGN_STATUS.md to reflect changes in front-panel controls, including the addition of an RGB LED panel and the consideration of RP2040 alongside STM32G0 as MCU candidates.
    - Revised FRONT_PANEL.md to clarify the concept of the RGB LED panel, detailing visual modes (VU, spectrogram, blank) and contextual feedback for parameter adjustments. Adjusted control descriptions and behavior implementation guidelines.
    - Improved front-panel SVG design to represent the new RGB matrix concept, including updated dimensions, visual states, and control labeling. Enhanced visual aesthetics and clarity of the design.
2026-10-31 Refactor front-panel design and documentation for simplified UI
    - Updated front-panel proposal to use five labeled push-turn controls and a compact seven-segment display, replacing rotary encoders and RGB LED panel.
    - Revised documentation in DESIGN_STATUS.md to reflect changes in user interface and MCU requirements.
    - Removed audio-data path dependency for display functionality, streamlining design considerations.
    - Adjusted SVG front-panel illustration to match new design specifications, including updated control labels and layout.
2026-10-31 pre amp updates
    [dsp.kicad_sch, preamplifier.kicad_sch]
2026-10-31 minor dsp updates
    [dsp.kicad_sch, preamplifier.kicad_sch]
2026-10-31 Update ADAU1701 integration and design status documentation with detailed input specifications and ADC interface requirements
2026-10-31 Update ADAU1701 integration documentation with detailed ADC input path verification steps and schematic status
2026-11-08 Restructured the repository.
    [ADAU1701.params, AudioAmplifier.kicad_pcb, AudioAmplifier.kicad_sch, Filter Design.xlsx, HeadphoneAmplifier.kicad_pcb, HeadphoneAmplifier.kicad_sch, control.kicad_sch, crossover.kicad_sch]
2026-11-08 Added front panel visual reference image
    [headphone_amp.kicad_sch]
